chushengzhink/2026tibei-mspm0g3507-icm42688/README.md

# MSPM0G3507 通用双轮差速底盘模板

本工程面向立创·天猛星 MSPM0G3507 开发板、TB6612 双路电机驱动和两只 MG513X 霍尔编码器电机。

SW6五向键映射已在实物上确认：上/左/下/中/右依次对应PA14/PA15/PA24/PB24/PB25。默认固件恢复完整底盘自检，任何运动都必须由垂直中键确认；电气检查见 [WIRING.md](WIRING.md)，软件与标定原理见 [ROBOT_SETUP.md](ROBOT_SETUP.md)，现场逐项验收和数据记录使用 [HARDWARE_ACCEPTANCE.md](HARDWARE_ACCEPTANCE.md)。

## 默认能力

- 左右编码器均由四根 GPIO 双边沿中断完成软件 4× 解码。
- 每个车轮使用独立 PID、前馈、轮径标定和方向配置。
- 20 ms 轮速闭环，计数速度使用系数 0.35 的一阶低通滤波。
- 编码器低频约束与ICM42688短时角速度互补融合，输出编码器航向、融合航向和融合角速度。
- 差速中点积分里程计使用融合航向输出 `x_mm`、`y_mm`，同时保留累计距离和累计 tick。
- 提供轮速、线速度/角速度、定距、原地转向和圆弧非阻塞接口。
- 定距、转向和圆弧使用加减速轨迹；完成条件需连续三个周期进入 2 mm 或 1°窗口。
- 8 个控制周期无编码器反馈触发堵转保护，约 160 ms。
- 电机驱动绝对PWM硬限制为20000/50000，即40%；默认安全自检仍使用`PID 11500 + 前馈6000`，输出不超过原35%。
- LF04通用读取仍不参与默认自检；独立竞速工程由编码器里程生成路线前馈、编码器+IMU融合生成航向阻尼，LF04作为按置信度加权的横向残差，在统一轮差预算内同时控制。
- 直线、转向、圆弧和速度模式在运动层使用融合航向/角速度纠偏；单轮PID仍只使用编码器。
- IMU读错或超过100 ms未更新时无跳变退化为编码器航向。
- 10 Hz RAM遥测可保存600条；公开记录结构为52字节，RAM内部以44字节紧凑格式保存相同字段（x/y分辨率0.25 mm），并可在停车后通过UART0导出27列CSV。记录包含累计航向、速度、实际PWM、LF04纠偏量、路线/航向/最终轮差和可用/恢复状态。
- 断开12 V后可在开机前按住中键进入OLED滚动标定页，无需连接电脑即可读取左右相对tick和BAD增量。

MG513X默认采用13 PPR、1:28减速比、65 mm轮径：

```text
13 × 28 × 4 = 1456 tick/轮
π × 65 / 1456 = 0.1402497 mm/tick
```

理论值只用于首次启动。左右轮必须分别按实车滚动距离标定。

当前一组正反各1 m滚动样本得到暂定值：左轮 `0.1413727 mm/tick`，右轮 `0.1434926 mm/tick`。它们已写入默认配置，但仍需通过500 mm/1 m实车回归确认最终距离精度。

## OLED滚动标定入口

断开12 V，只保留5 V逻辑供电；开机前按住垂直中键并保持车体静止。IMU校准完成后显示 `ROLL C=ZERO`，第二、三行是左右有符号相对tick，第四行是相对BAD。首次进入自动建立零基线，之后每次中键有效按压只清零显示基线，不启动电机。断电后不按中键重启即可返回普通自检。详细记录方法见 [HARDWARE_ACCEPTANCE.md](HARDWARE_ACCEPTANCE.md)。

## 软件分层

```text
chassis_self_test / 用户任务
        |
        +-- chassis：非阻塞公共API、20 ms调度、遥测
        |      +-- chassis_motion：轨迹、融合航向/角速度反馈、堵转与急停
        |      +-- chassis_heading_fusion：编码器低频约束与陀螺仪短时预测
        |      +-- chassis_odometry：融合航向中点积分并保留编码器航向
        |      +-- motor_velocity：左右轮PID、前馈、速度滤波
        |
        +-- ml_encoder + ml_quadrature：GPIO软件4×解码
        +-- ml_motor_driver：TB6612方向/PWM和40%绝对硬限幅
        +-- icm42688_service：姿态、映射后零偏校正角速度和健康状态
        +-- line_sensor + chassis_track_line_control：LF04四路物理质心PD控制与方向优先仲裁
        +-- chassis_track_mission：编码器+IMU胶囊赛道主任务
```

常用入口在 `code/chassis.h`：

```c
chassis_init(&g_chassis_default_config);
chassis_set_wheel_speed(100.0f, 100.0f);
chassis_set_velocity(120.0f, 0.0f);
chassis_move_mm(500.0f, 120.0f);
chassis_rotate_deg(90.0f, 60.0f);
chassis_arc(300.0f, 180.0f, 100.0f);

while (1) {
    chassis_poll();
}
```

所有命令均为非阻塞调用。应用应持续执行 `chassis_poll()`，并通过 `chassis_get_status()`检查运行、完成或故障状态。

## 目录

- `ml_libs/`：板级GPIO、定时器、UART、I²C、电机、编码器和传感器驱动。
- `code/`：PID、底盘配置、里程计、运动控制、遥测、自检和可选循迹。
- `tests/`：可在PC上运行的纯算法测试。
- `examples/legacy_drawing_task/`：已从默认工程移除的历史任务代码，仅供参考。
- `examples/attitude_monitor/`：已从默认工程移除的独立姿态显示示例。
- `user/project.uvprojx`：默认Keil底盘自检工程。
- `user/project_track.uvprojx`：独立竞速工程，定义`CHASSIS_TRACK_MISSION_BUILD=1`。
- `user/project_ball.uvprojx`：独立杆球工程，定义`BALL_BALANCE_BUILD=1`，不编译或初始化底盘电机、编码器、LF04和IMU。
- `user/project_ball_q3.uvprojx`：第三题独立地形学习与强制救援工程，定义`BALL_Q3_BUILD=1`，只链接舵机、MaixCam、PB24、OLED和可选UART0遥测。
- `user/project_h456.uvprojx`：H4/H5/H6联合工程，定义`H456_COMBINED_BUILD=1`，同时运行底盘循迹和任意目标滚球闭环，不链接两个独立应用或第三问滚球遥测。

## H题第3小题杆球工程

杆球源码已按当前HAL融合，舵机信号使用PB27/TIMA1_CCP1的独立50 Hz PWM，MaixCam使用UART2 PB15/PB16和115200 8N1，TIMG6提供1 ms时基并以10 ms运行控制。当前默认`BALL_AUTO_CONTROL_DISABLED`并开放正式序列；正常上电先以1500 us安全初始化，再按现有2000 us/s斜率移动到1525 us水平零点，连续3帧有效视觉后显示`BALL READY C=GO`，由PB24启动一次`+5→-5`。正常READY、闭环、序列切换和重捕获恢复均以1525 us为零控制；运行中按PB24立即中止并回到1500 us，本次上电不再重新启动。开机前保持PB24仍进入人工标定模式并使用1500 us安全中心。

`BALL_BALANCE_ALLOW_SEQUENCE=1`已启用，题面仍按±1 cm验收；软件内部序列判定为`+5.0 cm/±0.8 cm连续10 ms（不检查速度）→ -5.0 cm/±1.0 cm且|速度|≤1.0 cm/s捕获 → 捕获后连续合格500 ms`，总超时5000 ms。位置越界、失视或无效帧会清零端点确认。正式+5改用3.0 cm/s巡航；停车距离门或剩余误差2.5 cm任一命中后，以`1.2×位置误差`连续降速并限制在3.0 cm/s，18 cm/s²制动估计、0.25 cm余量和速度D=0不变。负向接近仍以-4.7 cm为控制目标，但当负向速度过大且预测停车点逼近`-3.2 cm`时会提前切入`MINUS_BRAKE`做正向制动，避免拖到`-4.7 cm`之后才刹。最终低速进入题面±1 cm即锁存捕获，捕获后使用`3×位置误差-1×实际速度`并限制在±2 cm/s；连续500 ms合格后进入`COMPLETE`，随后普通带积分位置环继续把球向-5中心收敛。最后120 ms窗口内保留收口余量，但不再继续加重末窗助力；负端短时失视时会继续维持制动而不是立刻回到平衡脉宽。卡滞判断使用180 ms内朝目标真实位移不足0.12 cm而不是单像素速度。总静止故障门仍为500 ms。舵机1300–1700 us、位置PID 0.8/0.40/0.30、速度P=27、5秒门、视觉安全门、PB24和26列遥测均不变。该源码按用户要求尚未运行回归、ARMCC构建或实车验收，不能据此宣称达到5 s；第3题全程物理断开小车12 V电机电源。

当前遥测启动由正式序列实际进入`TO_PLUS_5/TO_MINUS_5`统一触发，不再只依赖PB24启动分支。26列CSV中的`control_output_us`现在相对1525 us水平零点解释，`servo_target_us`和`servo_current_us`仍为绝对脉宽。终态回中后OLED第四行显示实际记录数`CSV Nxxx D=OUT`，其中`xxx`必须大于0；若显示`CSV EMPTY REBOOT`，或发送`D`仅收到`EMPTY`，说明本次没有可用记录，必须保持机械安全并重新上电重跑，禁止用空表头继续调整PID。非空CSV仍保持26列、600条×44字节，重复`D`不会清空，只有确认文件完整后才发送`C`。

## H题第三题独立 Q3 工程（新方案）

`user/project_ball_q3.uvprojx` 是与旧 `project_ball.uvprojx` 完全隔离的第三题工程，定义 `BALL_Q3_BUILD=1`。它只初始化 PB27 舵机 PWM、UART2 MaixCam、TIMG6 1 ms 时基、PB24 和 PB2/PB3 OLED；UART0仅作可选诊断/导出，不参与启动许可。不链接底盘、电机、编码器、ICM42688、LF04 或旧 `ball_*` 控制器。反馈只有 MaixCam 的小球位置和采集时间。正式默认模式使用13点、-6～+6 cm、1 cm间隔的双向地形LUT；每点包含局部平衡偏置、正反滚动/脱困脉宽和制动能力。当前第三题重点是负向高速提前制动：当负向速度过大且预测停车点逼近`-3.2 cm`时先切`MINUS_BRAKE`，并允许60–150 ms短失视窗口继续保持制动，而不是把球拖到`-4.7 cm`之后再收口。仓库自带表只是1300～1700 us内的安全首次标定基线，不能当作实车最终地形表。

先做离线地形标定：球放O点并等到`Q3 READY`，UART0发送`K`只进入`MAP CAL ARMED`，必须再按PB24才开始`O→+6→-6→O`扫描；扫描中PB24立即回中急停。完成后固件自动输出`Q3_MAP_BEGIN...Q3_MAP_END`，`L`可重复导出。把完整内容保存为CSV，执行`python tools/q3_fit_profile.py map.csv code/q3_ball_profile_generated.h`，再全量Rebuild/Download。生成器会拒绝缺少-6～+6任一格、未双向经过、阈值方向错误或相邻脉宽突变超过60 us的数据。

正式上电时把球放在O点。连续有效视觉后，固件根据固化LUT自动做O点小幅双向探测，验证方向、估算本次响应缩放和中位修正，并主动回O；探测位置超过±1.2 cm、方向反复错误或4.5 s无法回中会锁存`Q3 CAL FAULT`，OLED第三行显示`WHY POS LIMIT`、`WHY PLUS DIR`、`WHY MINUS DIR`、`WHY RECENTER`或`WHY TIMEOUT`，UART0同步输出`REASON=... FROM=...`。只有OLED显示`Q3 READY C=GO`才允许PB24启动5 s计时。控制器按预测停止位置提前制动，球首次进入+4.2～+5.8 cm立即折返，不等待速度归零；负向接近仍以-4.7 cm为控制目标，但速度过大且预测停车点逼近`-3.2 cm`时会先切`MINUS_BRAKE`，在60–150 ms短失视窗口内继续保持制动。最终低速进入-5.8～-4.2 cm后改以-5.0 cm保持，捕获中若再次高速穿越会退回强制动，直到`|速度|≤1 cm/s`连续80 ms后进入`Q3 PASS HOLD`；若已进入最后120 ms窗口，则满足终点低速条件可立即进入`Q3 PASS HOLD`。PASS后继续视觉保持，按PB24才回中并开放CSV导出。

卡滞判断使用180 ms内朝目标真实位移不足0.12 cm而不是单像素速度。第一级使用本格脱困脉冲；仍不动则反方向轻摇最多50 ms/0.25 cm，再向目标方向打到1300或1700 us安全边界160 ms，最多两轮，之后不提前ABORT而由5 s总门收口。进入最终-5合法带后禁止脱困把球推出。视觉年龄达到60 ms立即取消极限救援并回局部平衡，150 ms仍无有效帧才锁存失视故障并回1500 us安全中位。

MaixCam脚本仍为`maixcam/q3_maix.py`，继续输出32字节`<IhhffB3x>`帧且只识别小球；屏幕角落会显示`TX Q3 ttyS2 115200`、TX计数和循环间隔，超过250 ms会标`SLOW TX`。Q3 OLED应用已独立重写：上电页为`Q3 TERRAIN CTRL`，控制核心初始化期间第四行会依次显示`CORE START`、`CORE UART2`、`CORE SERVO`、`CORE TIMG6`、`CORE SAFE`和`CORE OK`；若某一步内部卡死，屏幕会停在最后一个`CORE xxx`阶段。core成功后会立即强制整页刷新到真实等待页，避免第4行残留`WAIT CORE`，随后才尝试初始化可选UART0。`Q3 PLACE BALL O`表示MSPM0正在等待视觉/O点条件，第三行会显示`NO VISION RX`、`BALL LOST`、`LOW SCORE`、`SLOW FRAME`、`VISION 1/3`、`VISION 2/3`或`MOVE TO O`；WAIT阶段慢帧仍允许累计到3帧进入自动微调，正式运动视觉超时安全门不放宽。UART0可用时发送`V`可输出当前视觉诊断计数、帧间隔和`diag=`分类。若控制核心初始化返回失败，会显示`Q3 CORE FAIL / STAGE UART2|SERVO|TIMG6|SAFE / ERR nn`并保持安全停机；若此时UART0可用，也会输出具体阶段和错误码。非运动100 ms只写变化行；自动微调、地图扫描和正式运动中只在阶段切换时更新第一行，其余行保持预先写好的`PB24 E-STOP`等静态提示。UART0空闲命令为`V`视觉诊断、`K`标定、`L`地图导出、`A/W`地形/备用波形模式和`D/C`正式CSV导出/清空；这些命令不能启动运动，PB24仍是唯一运动确认和运行急停。UART0不可用时Q3仍可运行，只是不能用串口命令或导出CSV。正式遥测为512条×40字节、10 ms周期、22列，包含LUT格、响应缩放、预测停止点、停滞进展和救援阶段/次数。最终仍须在现有μVision空闲时全量Rebuild并检查唯一32 KB SRAM布局。

## H题第五题

第五题能力已并入 `user/project_h456.uvprojx`，不再保留独立 `user/project_h5.uvprojx`。
第五题相关的 H5/H6 参数、循迹和滚球联动说明请直接看下面的 H4/H5/H6 联合工程。

## H题第4/5/6小题联合工程

联合固件上电默认进入H6，默认使用150 mm/s²加减速；H4为220 mm/s直线巡航，但启动后前1200 ms先用100 mm/s²柔起步，之后恢复150 mm/s²；H5/H6使用210 mm/s巡航，并在起步前1200 ms先用100 mm/s²柔起步、之后恢复120 mm/s²，从约5580 mm开始允许A点航向门计数。H4在启动后1500 mm首次通过B时冻结评分时间，H5/H6在进度达到5932 mm且累计航向连续3个20 ms周期进入355°～365°后冻结通过A的评分时间。通过后仍由LF04循迹并平滑减速，不执行第2问终点回正。H4/H5目标固定0 cm；H6不再用左右键预设目标，Maix有效且球位于±12.5 cm内时，MSPM0会先用当前厘米位置作为临时保持目标，避免上电追0 cm。READY前只要求球位于±12.5 cm且速度≤1 cm/s，PB24启动瞬间再由MSPM0锁定当前Maix厘米位置作为整圈滚球目标。上/下键只切换H4/H5/H6，方向键永不启动，PB24仍是唯一启动和运行急停键。

H4直线段使用单独的温和LF04参数：普通纠偏18%且不超过60 mm/s，外侧单探头28%且不超过80 mm/s。若融合航向相对启动方向偏离达到6°，H4临时进入航向优先修正，暂停LF04继续加大轮差；回到3°以内后恢复普通LF04融合。该保护只用于H4的A到B直线。H5/H6仍使用210 mm/s巡航，但弯道线控改为更温和的普通20%/70 mm/s、外侧单探头22%/60 mm/s、B0曲线保持16%/50 mm/s，并在曲线退出时加入120 ms渐退窗，以降低BC/DA弯道对滚球的横向冲击。H5/H6在CD第二直线中前段3200-4200 mm还会把航向反馈临时限到0.16 rad/s，并把最终轮差变化限制为每20 ms不超过8 mm/s，窗口外立即恢复当前控制。

启动前必须同时满足H456专用IMU静止校准约1.5秒、LF04白底连续稳定、Maix连续3帧有效，以及滚球稳定门：H4/H5为小球在目标±0.8 cm且速度≤1 cm/s连续500 ms，H6为小球位于±12.5 cm且速度≤1 cm/s连续500 ms；校准期间移动车体仍会清零重来。H6在校准、SETUP和READY期间都会用当前Maix位置更新临时目标，PB24启动边沿再锁定一次目标；`maixcam/h6_maix.py`仍只单向发送32字节视觉帧，不读取PB24也不改变协议。READY后若PB24尚未松开，OLED第四行显示`REL PB24`且不会启动；必须松开后看到`C=GO U/D=MODE`，再按PB24才会锁定并启动。PB24启动后叠加线性淡出的滚球控制偏置：H4为+60 us/6000 ms，H5为+100 us/6000 ms；H6按锁定目标分档，`target_cm>=+8 cm`为+190 us/5000 ms，`+3 cm<=target_cm<+8 cm`为+160 us/3000 ms，`-3 cm<target_cm<+3 cm`为+60 us/3000 ms，`-8 cm<target_cm<=-3 cm`为+60 us/5000 ms，`target_cm<=-8 cm`为+80 us/6000 ms。现有滚球闭环已经是位置P/D/I加速度P/D串级PID；负侧已从方向修正进入补偿降档，用于减少靠中心侧偏移，暂不新增PID。补偿不改变已锁定的`target_cm`，评分、±1 cm/±2 cm安全门和CSV仍按真实刻度目标计算。运行期OLED冻结；评分前误差达到±1.20 cm会立即锁存本轮滚球FAIL，±1.00～±1.20 cm之间需连续超过500 ms才锁存FAIL；连续100 ms超过±2 cm、视觉超时、脱困故障、底盘堵转或PB24急停仍会立即安全停车并把舵机回到1500 us。正常通过并停稳后继续保持滚球目标，结果页显示冻结时间和最大误差；再按一次PB24才回到1500 us并开放UART0导出。

H456上电后会先显示`H456 BOOT`。若OLED初始化成功但后续模块初始化失败，屏幕会停在`H456 INIT FAIL`并显示`STATUS xx`，避免被清屏黑屏误判为OLED损坏；第四行若为`LINE CFG FAIL`表示LF04线控参数校验失败，不是接线故障。如果连BOOT页都没有，优先检查OLED供电和PB2/PB3接线。

联合遥测只使用一个600条×44字节缓冲：H4每20 ms记录、覆盖12 s，H5/H6每60 ms记录、覆盖30 s。CSV记录底盘进度/航向/速度/PWM/LF04以及滚球目标/位置/区间误差峰值/速度/控制量/舵机、Maix原始`raw_x_px`和视觉年龄，并追加`expected_heading_deg`、`heading_error_deg`、`heading_gate_met`；`score_elapsed_ms`是本轮最终锁存结果，不是逐行实时计时。`maximum_ball_error_cm > 1.0`但`ball_score_passed=1`表示只出现短时/轻微边界超限，未达到评分确认门。导出后调参前先剔除坏行：每行必须35列、`time_ms`单调、舵机值在1300-1700 us合理范围内；字段缺失或粘行不参与最大误差计算。UART0仍使用`D/C/BUSY/EMPTY`。联合构建把旧底盘遥测容量缩为1且不链接第三问26.4 KB缓冲，完整Map仍须在首次Rebuild后确认唯一`RW_IRAM2`不超过`0x8000`。

## 构建

运行 PC 主机测试（需要 `gcc`）：

```text
powershell -NoProfile -ExecutionPolicy Bypass -File .\tests\run_host_tests.ps1
```

主机测试只验证可移植算法和安全状态机，不能替代 ARMCC 全量构建或实车验收。

Keil 全量构建：

```text
D:\Keil_v5\UV4\UV4.exe -b user\project.uvprojx -j0
```

杆球工程在μVision空闲时单独全量Rebuild `user\project_ball.uvprojx`；联合题使用`user\project_h456.uvprojx`。默认、竞速、滚球和联合四个工程均要求`0 Error(s), 0 Warning(s)`，不得并行启动UV4。

竞速工程不要在默认架空验收前烧录；验收完成后在现有μVision窗口打开并Rebuild：

```text
user\project_track.uvprojx
```

同一竞速固件还提供独立的纯LF04诊断入口：上电前按住上键，完成白底与IMU校准后松开上键；进入`LF ONLY READY`后用上/下键选择60、120、200、280或350 mm/s。READY页不检查当前B0-B15位型，按中键即可启动。转向只取LF04输出，IMU只记录，编码器仍负责左右轮闭环、累计里程和堵转。该模式不再按距离自动停车，可完整运行一圈；回到起点后按中键执行锁定急停，保持5 V时可先导出CSV，之后必须重新上电才能再次运行。B0会按当前任务速度无限期保持最后有效四路误差，初始B0按居中直行；所有`B1-B15`均为正常可用位型。恒定`350 mm/s`且越过6141.6 mm后仍运行的CSV表示进入了该诊断模式，不代表正式融合竞速。

正式竞速上电时不要按住上键，READY首行必须显示`RACE FUSION`。完成白底和IMU校准后，将车尾约定测试点放在A线、车头对准AB；READY页不检查当前LF04位型，按中键立即以当前编码器和融合航向建立零点并顺时针启动。路线为1.5 m直线、R500 mm半圆、1.5 m直线、R500 mm半圆，总长6141.6 mm。默认stage 0直线/弯道均为360 mm/s、加减速度400 mm/s²；stage 1/2仅作为未启用的可选档把直线依次提高到380/400 mm/s，弯道仍为360 mm/s。末段降至100 mm/s。

编码器里程生成AB/BC/CD/DA的期望航向和R500前馈，融合航向误差以`Kp=4.0`和`±0.35 rad/s`限幅修正，现有速度模式继续提供融合角速度反馈。理论路线长6141.6 mm只用于路线几何；车尾A点的首轮实测停车参考为5932 mm。航向门从DA起点约4570.8 mm开始允许计数，连续3个20 ms周期进入355°–365°即锁存，随后即使超过365°也不清除；终点从5742 mm减速，编码器进度达到5919 mm且航向门已锁存才制动。到5982 mm仍未同时满足则锁停并显示`FAULT LAP CHECK`。红外位型和A点横线均不参与停车判定。

制动后两轮连续3周期低于20 mm/s才进入`ALIGN TO START`原地回正。中键启动时锁存的融合航向仍是物理起点方向参考，但终点专用`finish_alignment_heading_bias_deg=+37°`补偿实车一圈后的累计航向偏差；回正误差为`wrap(start+37°-current)`，正值从车顶观察为顺时针。巡线航向继续使用`Kp=4.0`，终点回正独立使用`Kp=2.0`和`±0.35 rad/s`，LF04继续记录但权重为0。补偿误差首次进入±1°（当前启动零点下396°–398°）即锁存停车；双轮完全停稳前即使融合航向离窗也不得反向。两轮连续3周期低于20 mm/s后以±2°（395°–399°）验收，超出才从静止重新微调。主动回正限时3秒；截止前已锁存停车时允许最多300 ms无动力停稳宽限。初始误差超过45°、主动阶段超时或宽限后仍未停稳/超差会显示`FAULT ALIGN`并锁停。OLED `TIME`与CSV `lap_total_ms`都从启动中键计到回正完成，包含巡线、制动和回正；完整圈航向门仍单独使用360°目标。`LAP COMPLETE`只表示状态机正常结束，第四行按20秒和编码器估算±20 mm分别显示`LAP CHECK PASS`、`TIME LIMIT FAIL`、`EST POS FAIL`或`TIME+POS FAIL`；位置结果不代表IMU故障，也不替代外部尺量。

LF04从左到右为PA31/PA12/PB8/PA27，探头中心相对模块中心为`-40.25/-7.25/+7.25/+40.25 mm`。所有低电平探头按`error=-average(position)/40.25`计算归一化四路质心：左侧黑线得到正误差并使左轮减速、右轮加速，右侧完全对称；B6、B9、B15质心为0。所有`B1-B15`均可用，只有`B0`表示丢线。控制器每20 ms执行`Kp=1.2、Ki=0、Kd=0.20`的PD控制；首个有效样本预装D历史，避免启动冲击。普通位型采用当前中心速度的22%纠偏且总偏置不超过90 mm/s；B1/B8最外侧单探头立即采用35%纠偏和120 mm/s总偏置上限。左右误差直接反向时首周期把有效误差置0，连续第二周期才接受；居中和同侧变化不延迟。正式竞速恢复已验证的LF04方向优先仲裁：B0无限保持最后确认误差和增强状态；LF04纠偏非零时只接受同向的路线前馈与航向反馈，反向路线量不得抵消或反转LF04回线方向；LF04居中时路线与航向正常接管。红外不参与终点双门，运行中中键仍立即急停。

纯LF04和正式竞速都不启用实验性弯道方向记忆。B1/B8立即使用35%/120 mm/s增强，B0继续保持最后确认的质心误差；任意新有效位型在现有反向确认规则后立即接管。实测表明原弯道记忆可能在直线入口继续输出`+89～+120 mm/s`并造成持续转向，因此31%/110 mm/s保持量和1200 mm退出门只保留为未启用的实验配置。正式竞速仍分别记录路线前馈和航向反馈，但只有在不违背非零LF04回线方向时才参与最终轮差。

GPIO输入初始化会先清除遗留输出使能；竞速初始化、启动边沿和每次20 ms采样都会把四路LF04重新确认为普通GPIO上拉输入。LF04固定使用白底高、黑线低逻辑，期望白底为`WF`，归一化采用`(~R)&0x0F`，不再把开机瞬态保存为极性基线。IMU校准期间还必须连续10个20 ms样本得到`RF`才允许进入READY；否则保持停车并显示`LF WHITE WAIT`。启动前重申失败会禁止启动，运行中失败会立即锁停并显示`LF GPIO FAULT`。RUN第四行每秒交替显示`Rr Ww Bb`与`LFb Ln DnHn`，分别用于核对原始电平/固定白底期望/归一化黑线位，以及丢线恢复/距离门/航向门。

UART0固定为PA10/PA11、115200、8N1、无流控。竞速或纯LF04模式完全停稳后发送单个`D`导出纯27列CSV，确认文件保存后再发送`C`清空RAM；运行和制动期间两者均不执行，仅每秒最多回复一次`BUSY`。`line_correction_mm_s`仍表示LF04原始分量，新增`mission_progress_mm`、`expected_heading_deg`、路线前馈轮差、航向反馈轮差、红外权重和最终轮差，可直接还原正式仲裁。纯红外中键锁停会结束遥测会话并写入纠偏为0的最终快照。编码器和融合航向为不回绕的累计值，原始IMU Yaw保留回绕诊断；同时间戳立即采样覆盖上一条，导出的时间戳严格递增。SSCOM必须关闭“发→/收←”方向标记、时间标签、定时发送和自动换行，只发一次ASCII `D`或十六进制`44`并等待完整导出。

验收标准为 `0 Error(s), 0 Warning(s)`。烧录和上电前必须先阅读 `WIRING.md`，实车自检和标定步骤见 `ROBOT_SETUP.md`。

Fusion算法授权保留在 `ml_libs/FUSION_LICENSE.md`，硬件规格书和原始资料均未从仓库删除。

杆球第三题当前控制基线：1500 us为安全/人工/导出回中，1525 us为正常READY与闭环水平零点；Maix分段`FIXCM`为唯一厘米输入；正向3.0 cm/s巡航、18 cm/s²制动估计、2.5 cm固定接近区和1.2倍位置参考；负向接近为3倍位置参考，最终捕获只允许低速进入并以-5.0 cm保持，捕获中高速穿越会退回强制动。正式序列脱困启动前速度绝对值必须≤1 cm/s。
