chushengzhink/2026tibei-mspm0g3507-icm42688/tmp/pdfs/route_review/page-1.png

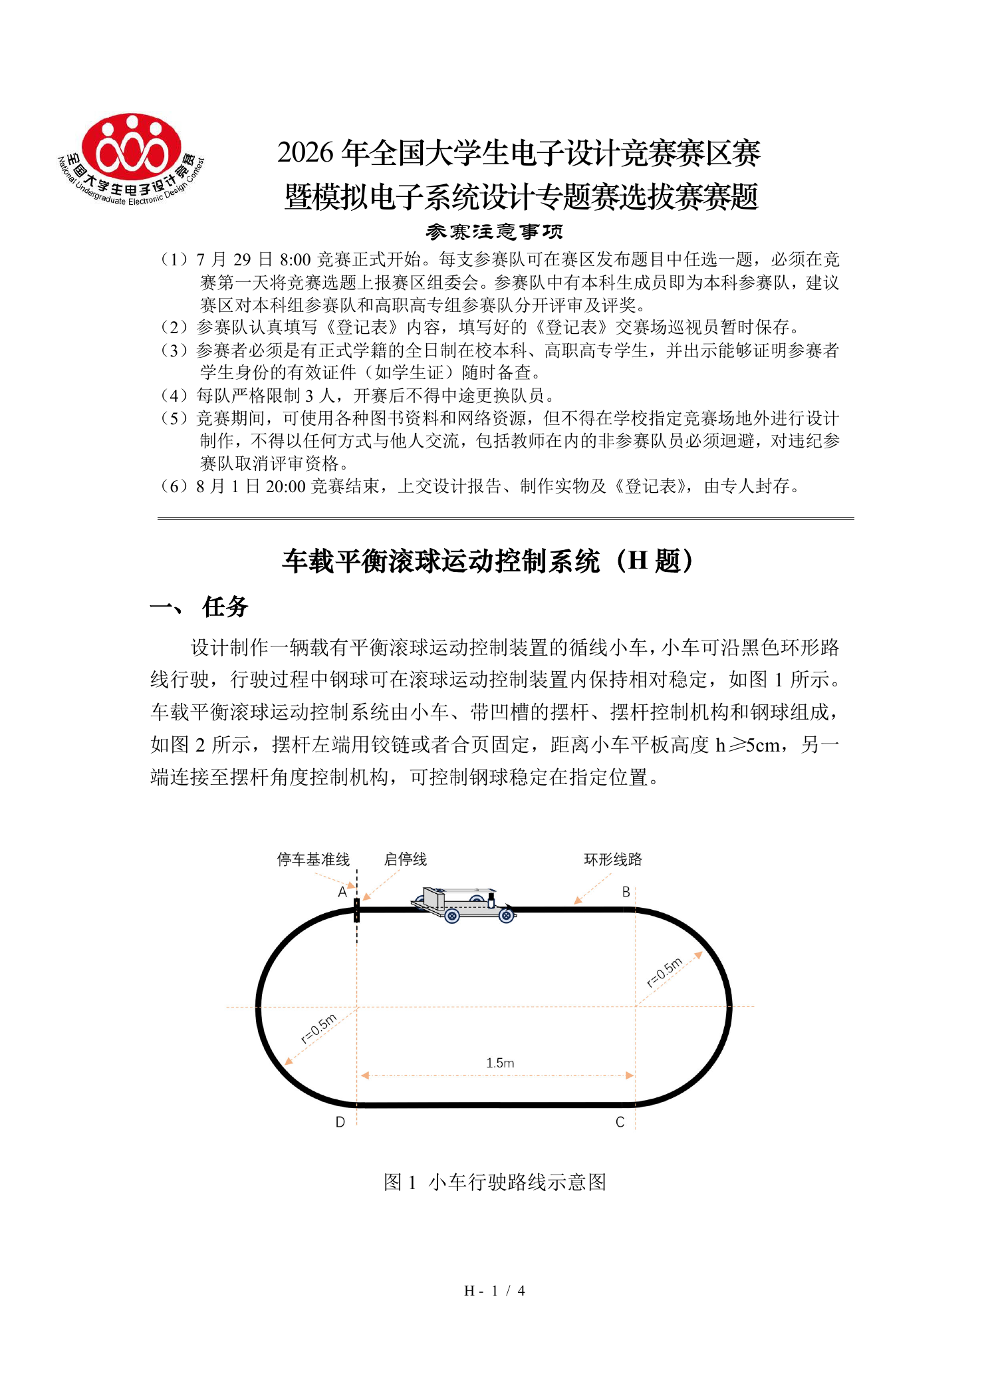
tmp/pdfs/route_review/page-1.png
