chushengzhink/2026tibei-mspm0g3507-icm42688/红外循迹模块.png

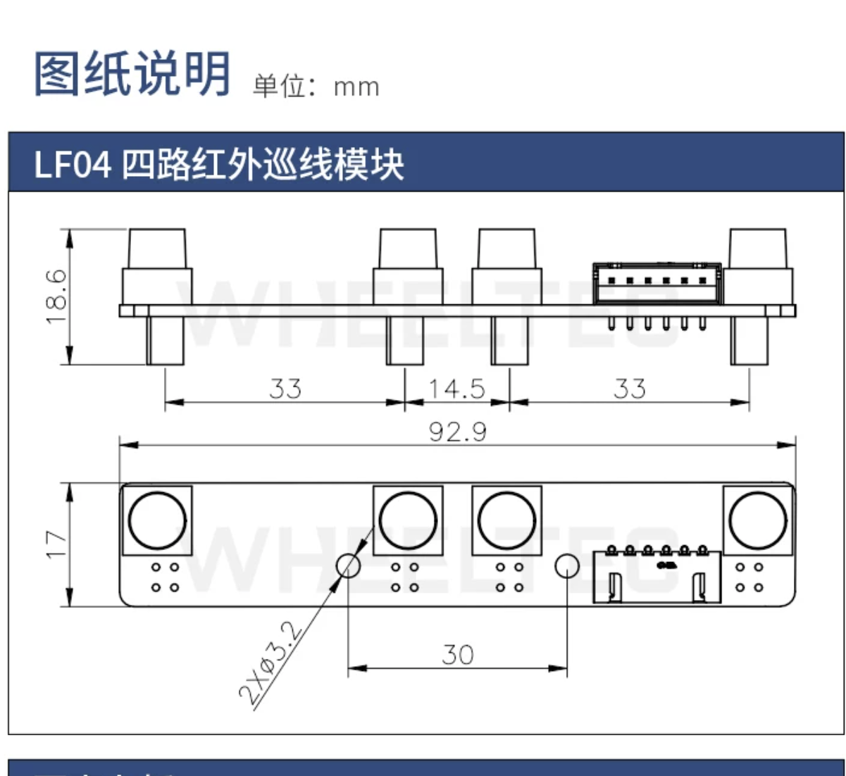
红外循迹模块.png
