chushengzhink/2026tibei-mspm0g3507-icm42688/ROBOT_SETUP.md

# 通用双轮底盘自检、标定与API说明

本文件说明自检行为、标定原理和公共 API；实际烧录、架空、地面测试和数据签字请逐项填写 [HARDWARE_ACCEPTANCE.md](HARDWARE_ACCEPTANCE.md)。

## 默认自检流程

SW6动作映射已经实测确认，当前构建设置为 `CHASSIS_SW6_MAPPING_DIAGNOSTIC=0`，恢复完整底盘自检。垂直中键对应PB24，方向键不会启动运动；开机保持右键PB25只会进入永久停车的UART诊断页。

### 中键操作

一次有效中键操作是垂直按下0.1–0.3秒后完全松开。程序使用60 ms时间消抖：过快轻触可能被过滤，长按只产生一次事件，下一次操作前必须先松开。IMU校准期间不会接受运动确认；唯一例外是开机前持续按住中键，会在校准完成后进入不驱动电机的滚动标定页。

### OLED提示与操作

| OLED提示 | 用户操作 | 程序动作 |
| --- | --- | --- |
| `KEEP STILL` | 不触碰小车 | IMU采集300个静止样本 |
| `ROLL C=ZERO` | 释放中键后手推标定；中键可重新清零 | 显示左右相对tick和相对BAD，不发送运动命令 |
| `LIFT+PRESS KEY` | 架空两轮，垂直按中键 | 左正、左反、右正、右反、双轮闭环各约1秒 |
| `FUSION F/S STOP` | 12 V断开时手动转动车体；串口发送`S`退出 | 10 Hz记录编码器、IMU与融合结果，不发送运动命令 |
| `GROUND+PRESS KEY` | 放到平地后按中键 | 执行500 mm直线 |
| `PRESS FOR +90` | 确认周围安全后按中键 | 执行+90°原地转向 |
| `PRESS FOR -90` | 按中键 | 执行−90°原地转向 |
| `TEST COMPLETE` | 不再按键 | 自检完成，电机保持停止 |
| 任一电机运行页面 | 按中键 | 立即锁定急停，必须重新上电 |
| `SELF TEST ERROR` | 断开12 V后排查 | 保持停车，不继续后续步骤 |

首次运动前应能够立即断开12 V，架空时不要手持车轮或让线缆靠近轮胎。

### OLED滚动标定模式

1. 物理断开12 V，只保留5 V逻辑供电；将车辆放在样本起点。
2. 开机前按住垂直中键，并在整个IMU校准期间保持车体静止和中键按下。
3. 出现 `ROLL C=ZERO` 后松开中键。首次进入已自动建立零基线。
4. 第二、三行分别显示 `L +0000000`、`R +0000000` 格式的有符号相对tick；第四行显示自基线以来的 `BAD` 增量。
5. 每完成一个样本后记录屏幕；需要下一个样本时按住中键超过60 ms再松开，确认tick与BAD重新从0开始。
6. 标定页内中键不会启动电机，上、左、下、右也无功能。退出只能断电，然后不按中键重新开机。

显示值是相对最近一次清零的增量，不会清除底层累计计数。七位tick超过范围时饱和显示为 `±9999999`。

### 校准与AB状态显示说明

第二行 `L AxBx R AxBx` 显示PB23、PB12、PB4、PB5的实时GPIO电平，不再显示解码器内部缓存。编码器插头全部拔掉时，内部上拉应使其稳定显示 `L A1B1 R A1B1`。固件将每一行先组成最终16字符内容，再通过批量软件I²C写入；不会先显示占位数字0再覆盖真实数字，因此正常情况下不应出现0/1假闪烁。

出现 `MOVE RETRY` 时，第四行显示类似 `G:034 A:101`：

- `G`是陀螺仪模长的0.1 dps单位，`034`表示3.4 dps。
- `A`是加速度模长的0.01 g单位，`101`表示1.01 g。
- 静止校准要求陀螺仪总模长小于3.0 dps、加速度模长处于0.85–1.15 g。

若校准能够正常采样，第四行必须从 `CAL:000/300`连续增加到300。它不会再永久用`CAL:000`掩盖读取错误或主循环超时。

校准结束后，第四行按实测物理通道顺序显示：

```text
K U1L1D1C1R1
```

`U/L/D/C/R`依次表示上、左、下、中、右，对应PA14、PA15、PA24、PB24、PB25。未操作时均为1，操作对应方向时只有自己的位变为0。只有`C`参与确认和急停。

### ICM42688安装方向

当前模块元件面朝下并水平安装。传感器 `+X` 指向车尾；站在车头正前方、面向车尾观察时，传感器 `+Y` 指向观察者右侧，也就是车辆自身左侧；传感器 `+Z` 指向地面。车体姿态坐标保持 `+X` 向前、`+Y` 向左、`+Z` 向上，因此配置为：

```text
source_axis = {X, Y, Z}
axis_sign   = {-1, +1, -1}
```

从上方观察，Fusion库输出仍遵循逆时针正、顺时针负。当前实车运动接口和编码器航向沿用既有约定：`+90°`实测为顺时针，所以融合入口使用独立的`imu_heading_sign=-1`将IMU角速度转换到编码器正方向；该符号转换不改变三维安装映射。IMU每次上电仍必须静止完成300样本校准。

20 ms底盘周期使用陀螺仪短时预测、编码器低频约束形成融合航向；时间常数为1.0 s，融合角速度采用75% IMU和25%编码器。IMU超过100 ms未更新或单周期变化超过25°时，系统连续退化为编码器航向，恢复时不跳变。单轮PID仍只使用编码器，IMU只在底盘运动层参与直线航向、转向/圆弧进度及角速度反馈。

### 按键没有反应时的排查顺序

1. 查看第四行 `K UxLxDxCxRx`，未操作时五位都应为1。
2. 若对应动作不能把自己的位变为0，断开5 V和12 V，检查开关触点、公共GND、焊点和对应GPIO走线。
3. 若一个动作出现多个0，检查信号间短路。
4. `C0`能正常显示但没有启动时，确认页面已经进入`LIFT+PRESS KEY`且按住超过60 ms，并先完全松开后重试。
5. 方向键只用于电平诊断，按上、左、下或右不会启动自检。

更完整的TM-2027六脚定义、内部上拉原理和万用表通断测试见 [WIRING.md](WIRING.md)。

## 编码器验收

软件4×解码在PB23/PB12/PB4/PB5四根线上均使用双边沿中断。AB状态表只接受相邻转换；`00→11`、`01→10`等两位同时变化不增加位置，只增加非法转换计数。

静止时某轮若在 `A0B0` 与 `A1B1` 之间反复切换，表示A、B两位正在同时变化，不是正常正交相位。固件已对双边沿输入启用GPIO硬件迟滞以抑制窄噪声，但不会把这种非法转换计入位置。若BAD仍持续增加，应分别测量两相信号：检查A/B是否误并联、编码器3.3 V与GND是否稳定、插头针序是否正确；长线或开漏输出可在A、B各增加约4.7 kΩ到3.3 V的外部上拉，不能靠软件忽略错误来替代电气修复。

1. 用万用表或示波器确认四路高电平约3.3 V，不超过3.6 V。
2. 拔掉两只编码器插头时，确认四路实测约3.3 V且OLED稳定显示 `L A1B1 R A1B1`。
3. 如需逐脚验证，可将PB23、PB12、PB4、PB5分别通过1 kΩ电阻接GND；对应A/B位应稳定变为0，断开后恢复1。
4. 进入OLED滚动标定页，缓慢手转左轮输出轴一整圈，相对计数绝对值应接近1456。
5. 中键清零后对右轮重复一次，相对计数绝对值也应接近1456。当前实测左轮1456、右轮绝对值1498，BAD增量均为0。
6. 正向推动车体时左右累计计数都应为正。
7. 分别正反转至少10圈，非法转换率应低于0.1%。

方向不一致时优先核对A/B接线。确认接线无误后，只修改 `code/chassis_config.c` 中对应轮的 `encoder_sign` 或 `motor_sign`，不要同时随意交换多组线。

## 轮距与每tick距离标定

默认值：

```text
left mm_per_tick   = 0.1413727
right mm_per_tick  = 0.1434926
effective_track_mm = 214.2
```

`CHASSIS_DEFAULT_MM_PER_TICK=0.1402497` 仍保留为65 mm轮径的理论参考值，不再作为当前左右轮的实车配置。当前 `214.2 mm` 是两轮接地点中心距的首轮实测值。旧值 `128.6 mm` 下，双向 90°命令均只转到约 54°；按 `90 × 128.6 / 214.2 ≈ 54.0°` 计算，两者相互吻合。

### 左右轮独立标定

1. 断开12 V并进入OLED滚动标定页，在实际比赛轮胎、载荷和地面条件下让车辆直线滚动1–2 m。
2. 每次在起点用中键清零显示基线；每个方向至少做5次，记录实际距离和左右相对tick。
3. 对每轮计算 `mm_per_tick = 实际距离 / |相对tick|`。
4. 去掉明显打滑数据，取稳定样本平均值，分别写入左、右轮配置。
5. 再执行1 m直线，基线目标是距离误差不超过1%。

当前用户选择先采用一组正反各1000 mm样本：前进 `L+7037/R+6951`，后退 `L-7110/R-6987`。按合并距离除以合并绝对计数得到：

```text
left  = 2000 / (7037 + 7110) = 0.1413727 mm/tick
right = 2000 / (6951 + 6987) = 0.1434926 mm/tick
```

这是一组正反方向的暂定值，不等同于已经完成多次重复性验证。写入后必须重新验证500 mm直线和双向90°；若距离超差或偏移明显，应增加滚动样本，不先调整PID。

### 有效轮距标定

1. 先重复执行双向90°，再执行双向360°。
2. 使用外部角度基准记录实际转角，按 `新轮距 = 旧轮距 × |命令角度| / |实际角度|` 计算修正值。
3. 实际转角小于命令角度时增大 `effective_track_mm`；实际转角大于命令角度时减小。
4. 每次只调整一个参数并重复至少5次。
5. 基线目标是90°转向误差不超过2°。

有效轮距包含轮胎侧滑等综合影响，通常不等于尺量的几何轮距。更换地面、轮胎或载荷后应重新标定。

## 轮速参数

默认20 ms控制周期下：

| 参数 | 默认值 |
| --- | --- |
| KP | 700 |
| KI | 55 |
| KD | 0 |
| 前馈 | 6000 |
| PID输出限制 | ±11500 |
| PID积分限制 | ±5750 |
| 默认自检最大合成输出 | 约±17500（35%） |
| 电机驱动绝对PWM硬限制 | ±20000（40%，仅竞速配置可用满） |
| 速度滤波系数 | 0.35 |

先标定机械方向和编码器比例，再调整PID。推荐从低速架空测试开始，观察目标轮速、滤波轮速和PWM，不要用提高PWM限幅掩盖接线、摩擦或供电问题。

## 非阻塞API

初始化并持续轮询：

```c
if (chassis_init(&g_chassis_default_config) == ML_STATUS_OK) {
    while (1) {
        chassis_poll();
        status = chassis_get_status();
    }
}
```

运动命令：

```c
chassis_set_wheel_speed(left_mm_s, right_mm_s);
chassis_update_wheel_speed(left_mm_s, right_mm_s);
chassis_set_velocity(linear_mm_s, angular_rad_s);
chassis_update_velocity(linear_mm_s, angular_rad_s);
chassis_move_mm(distance_mm, max_speed_mm_s);
chassis_rotate_deg(angle_deg, max_angular_deg_s);
chassis_arc(radius_mm, angle_deg, max_speed_mm_s);
chassis_stop();
chassis_emergency_stop();
chassis_reset_pose(x_mm, y_mm, heading_deg);
```

- 定距允许正负距离。
- 当前实车约定中，转向角正值为从车顶向下看的顺时针，负值为逆时针；编码器航向和融合航向均使用该约定。
- `chassis_update_wheel_speed()`只更新已运行的直接左右轮目标，不重置PID或堵转计数，并始终保持`CHASSIS_MODE_WHEEL_SPEED`，不会叠加IMU角速度反馈；首个命令仍调用`chassis_set_wheel_speed()`。
- `chassis_update_velocity()`只更新已运行的`VELOCITY`命令，不重置PID、堵转计数或融合基线；赛题20 ms循环必须使用它，首个命令仍调用`chassis_set_velocity()`。
- 圆弧半径必须大于半轮距，角度正负决定转向方向，车辆默认向前沿弧线运动。
- 新的定距/转向/圆弧命令在另一个轨迹命令运行时返回 `ML_STATUS_BUSY`。
- 急停会锁定后续运动，必须重新初始化或重新上电。
- 默认自检通过`chassis_set_imu_sample()`同步输入原始Yaw、映射且扣除零偏后的车体Z轴角速度和时间戳；旧`chassis_set_imu_yaw()`仅保留为不启用融合的兼容接口。

## 可选LF04调用

```c
line_sample_t sample = line_sensor_read();
if (!sample.io_fault && !sample.lost) {
    uint8_t active_sensors = sample.black_bits;
}
```

竞速工程由`chassis_track_line_control`按`-40.25/-7.25/+7.25/+40.25 mm`计算四路有效探头的物理质心；`error=-average(position)/40.25`。红外环使用`Kp=1.2、Ki=0、Kd=0.20`的PD控制，首个有效样本不产生D冲击，PID输出限制`±1`。普通位型使用22%纠偏和90 mm/s总偏置上限，B1/B8最外侧单探头继续立即使用35%和120 mm/s。直接左右反向首周期抑制为0，连续第二周期或随后B0确认；居中和同侧变化立即接受。B0无限期复用最后确认误差且保持当前任务速度及外侧增强，首次B0按误差0且不增强处理。

纯LF04模式使用同一PD且不启用实验性弯道方向记忆。B1/B8仍立即使用35%/120 mm/s外侧增强；B0按原速度无限保持最后确认误差，新有效位型经两周期反向确认后立即接管。曾启用的31%/110 mm/s长期保持和1200 mm退出门会在直线入口继续保持弯道方向，现已关闭。正式竞速在同一红外优先控制之上加入编码器里程与IMU融合路线辅助，纯LF04中的IMU仍只记录不转向。

## RAM遥测与UART0

### UART0安全诊断模式

1. 物理断开12 V，开机前按住右键PB25，并保持车体静止完成IMU的300样本校准。
2. 出现`UART DIAG STOP`后松开右键。该状态不会执行任何运动命令，中键和其他方向键也无效；退出只能断电后不按右键重启。
3. OLED第二行正常应为`BRD I0002 F11`，表示4 MHz MFCLK、16×过采样和115200波特率的实际硬件分频。
4. 固件每秒自动发送`UART0,115200,TX,nnnn\r\n`，无需先发送命令。第三行显示横幅次数和TX超时数。
5. 发送一个ASCII `D`时，第四行应显示`RX44 E00 O0000`，串口回复`RX,44,ERR,00\r\n`。诊断模式把所有输入都当作测试字节，不会执行`D/C`、导出CSV或清空RAM。
6. 横幅乱码但OLED分频正确且TX次数增加时，检查PA10到适配器RX、共地、3.3 V TTL和约`8.68 us/bit`波形；横幅正确但不是`RX44`时，检查适配器TX到PA11。`E`非0表示overrun/break/parity/framing/noise，`O`为软件队列溢出。

诊断通过后必须断电、不按右键正常启动，再进行空缓存CSV验证。自动横幅只存在于诊断模式，不会混入正常CSV。

运动时每100 ms记录一次；`LIFT+PRESS KEY`页面发送`F`后，停车状态也按相同周期记录。竞速制动开始后会自动继续被动采样；首次停稳后转入原地回正并恢复运动采样，最终回正停稳才结束会话。共600条，缓冲满后停止新增并置溢出标志，不覆盖旧数据。立即采样若与上一条时间戳相同会覆盖上一条，较小时间戳会被拒绝，因此CSV时间戳严格递增。公开记录结构为52字节，RAM内部以44字节紧凑格式保存同等字段；tick和航向保持原精度，x/y分辨率为0.25 mm：

- 时间戳、左右累计tick：32位整数。
- x/y：32位浮点毫米。
- 编码器/融合航向：有符号32位0.01°累计值，可完整显示180°、270°和约360°；原始IMU Yaw仍为有符号16位回绕诊断值。
- 融合角速度：有符号0.01°/s定点数，超过范围时饱和。
- 融合有效位：`0/1`，表示该样本中IMU是否实际参与融合。
- 目标/实际中心速度：有符号0.1 mm/s定点数。
- 左右PWM：驱动端实际施加值的绝对计数，范围0–20000。
- LF04位型、纠偏和状态：低4位十进制输出、有符号整数`line_correction_mm_s`，以及`line_usable/line_recovering/line_pattern_invalid`三个标志。
- 正式融合诊断：任务进度、期望航向、路线前馈轮差、航向反馈轮差、LF04有效权重和最终轮差；纯LF04模式下新增融合字段保持为0。

`chassis_init()`会在每次上电初始化时清空 RAM。默认自检的架空五段和地面运动都会记录；未启用`F`调试时，等待页面和完全停车不写入，所以仍可利用等待页面产生的时间戳间隔区分运动段。五段架空、500 mm和双向90°的总运动时间远低于约60秒容量，不需要在地面连接电脑或发送 `C`。

UART驱动显式启用硬件FIFO，并把RX中断阈值设为1字节；`uart_try_read()` 在软件队列为空时还会直接轮询硬件RX FIFO，避免单字节RX中断未到达软件队列时丢失命令。单独发送一个ASCII `D`或`C`必须立即处理，不需要附加 `0`、连续字符或换行。TX每个字节在写入前后都等待UART `BUSY`清零，成功返回即表示该字节已经发送完成；任何超时都会立即终止本次CSV导出。

每次重新构建和烧录后，先保持12 V断开：静止完成IMU校准并停在 `LIFT+PRESS KEY`，通过COM3发送单个 `D`。空缓存也必须返回且只返回完整表头：

```text
time_ms,left_ticks,right_ticks,x_mm,y_mm,encoder_heading_deg,fused_heading_deg,imu_yaw_deg,fused_yaw_rate_dps,fusion_active,elapsed_ms,lap_total_ms,target_center_mm_s,actual_center_mm_s,left_pwm_count,right_pwm_count,line_bits,line_correction_mm_s,line_usable,line_recovering,line_pattern_invalid,mission_progress_mm,expected_heading_deg,route_feedforward_bias_mm_s,heading_feedback_bias_mm_s,line_weight_pct,final_steering_bias_mm_s
```

首次复验建议开启接收十六进制显示。空缓存表头必须恰好为435字节，以`74 69 6D 65 5F 6D 73`开头、以`5F 73 0D 0A`结尾；文本模式应显示上述完整27列表头。重复发送 `D`应重复得到同一结果。若无输出或出现 `~`、`}k`等乱码，不得接通12 V或重跑地面测试；保存第一次导出的原始十六进制，并测量PA10空闲电平及约`8.68 us/bit`的实际位宽。

### 无电机航向融合调试

1. 物理断开12 V，只保留5 V，正常开机并静止完成IMU校准，停在`LIFT+PRESS KEY`。
2. 发送`C`显式清空旧记录，再发送`F`；`F`不会自行清空RAM，也不会发送电机命令。
3. OLED显示`FUSION F/S STOP`。第二行`E/F`为编码器/融合航向，第三行`I/R`为原始IMU Yaw/融合角速度，第四行`IMU ON/OFF`和`N`表示融合有效性与记录数。
4. 从车顶向下顺时针手动转动约90°：原始`I`应为负变化，`F/R`应为正变化；反向转动时符号相反。轮子不计数时，保持静止后融合航向会按约1 s时间常数平滑回到编码器约束。
5. 发送`S`停止采样并返回`LIFT+PRESS KEY`，再发送`D`导出。采样期间`D/C`返回忙，中键和方向键都不会启动运动。

`F/f`只允许从`LIFT+PRESS KEY`进入，`S/s`只在融合采样页生效。任何运动入口、普通停车或急停都会防御性关闭空闲采样。右键开机进入的`UART DIAG STOP`仍把所有字节仅作为RX诊断，不执行`F/S/D/C`。

离线现场流程：

1. 保持独立5 V逻辑供电，按正常顺序完成IMU校准和架空五段自检。
2. 将车放到地面，在 `GROUND+PRESS KEY`、`PRESS FOR +90` 和 `PRESS FOR -90` 等待页面各停留数秒，再按中键执行500 mm、`+90°`和`-90°`并完成外部测量。
3. `TEST COMPLETE` 完全停车后先断开12 V，但持续保持5 V；不要复位、重新烧录或切换可能短暂掉电的电源。
4. 保持5 V将车搬回电脑旁。停车搬运不会新增记录，也不会改变已经存入RAM的样本。
5. 使用3.3 V TTL USB转串口，适配器RX接PA10/UART0 TX、TX接PA11/UART0 RX，并连接GND；适配器VCC悬空，不得反向给开发板供电。
6. 串口设为115200、8N1、无流控，先发送ASCII `D`并保存CSV。核对表头和数据行完整后，才允许发送ASCII `C`清空记录和溢出标志。

RAM是易失存储器。测试完成后若断开5 V、复位或重新烧录，尚未导出的数据无法恢复。不要在导出前发送 `C`。

UART0命令：

- 发送ASCII `D`：导出带表头CSV。
- 发送ASCII `C`：清空记录和溢出标志。
- 在`LIFT+PRESS KEY`发送ASCII `F`：开始无电机融合采样，不清空RAM。
- 在`FUSION F/S STOP`发送ASCII `S`：停止融合采样并返回等待页。

运动状态下不会执行导出或清空命令。分析时按时间戳间隔和左右轮运动特征分出架空五段、500 mm、`+90°`和`-90°`；分别比较`encoder_heading_deg`、`fused_heading_deg`和原始`imu_yaw_deg`。原始IMU Yaw与当前软件航向正号相反，比较时先乘以-1；融合航向应连续并接近外部实测角度。没有磁力计，因此长期打滑仍必须依靠外部角度基准判断。

## 测试与构建

PC主机测试覆盖：

- 16种AB转换、正反完整相位和非法跳变。
- 直线、原地旋转、圆弧和双航向里程计。
- 编码器–陀螺仪互补融合、符号转换、超时回退和恢复连续性。
- 加减速、三周期完成、堵转与急停。
- 左右速度滤波、换向PID复位。
- 遥测容量、溢出、52字节布局、累计航向、重复时间戳覆盖、27列CSV、六个正式融合字段、纠偏量正负/饱和、停止态10 Hz采样和运行中`BUSY`。
- 纯LF04和正式竞速全部16个位型的物理质心、单周期响应、普通22%/90 mm/s、B1/B8增强35%/120 mm/s、B0状态记忆与无限保持；正式融合另覆盖LF04与路线/航向同向叠加、反向LF04优先和分量遥测。
- 竞速A点零位快照、四赛段期望航向、拆分前馈/航向反馈、5919 mm距离门、DA段内355°–365°连续3周期锁存航向门和5982 mm锁停。
- 自检最终16字符格式，确保实时AB、CAL、MOVE和STATUS不会通过占位数字二次覆盖。

从仓库根目录运行全部29组 PC 主机测试（原底盘/竞速/滚球回归加H456任务、应用及遥测测试，需要 `gcc`）：

```text
powershell -NoProfile -ExecutionPolicy Bypass -File .\tests\run_host_tests.ps1
```

主机测试不能替代 ARMCC 全量构建、烧录或实车验收。

## H题第3小题杆球操作

独立杆球固件为`user/project_ball.uvprojx`，不初始化底盘；现场仍必须断开小车12 V电机电源。Maix和模型保持320×224，以32字节帧直接发送厘米位置，MSPM0只用厘米值控制并继续检查score≥0.20、valid、连续3帧和150 ms超时。当前Maix脚本仅在`X ±84%`、`Y ±20%` ROI内使用0.20低置信度阈值筛选目标，该值只用于本轮ROI限定调参。

当前`BALL_AUTO_CONTROL_MODE=BALL_AUTO_CONTROL_DISABLED`且`BALL_BALANCE_ALLOW_SEQUENCE=1`。正常上电先以1500 us安全初始化，再按2000 us/s斜率移动到1525 us水平零点并等待连续3帧有效视觉；显示`BALL READY C=GO`后把球放在O点并按PB24启动正式`O→+5 cm→-5 cm`串级序列。READY、闭环和重捕获恢复均以1525 us为零控制；运行中PB24立即中止并回到1500 us，本次上电不再重新启动。+5误差≤0.8 cm连续10 ms即折返，不检查速度；其巡航降为3.0 cm/s，停车距离门或2.5 cm固定接近区任一命中后，以`1.2×位置误差`连续降速并限制在3.0 cm/s。-5保持5 cm/s巡航、24 cm/s²制动估计和0.15 cm余量，进入2.0 cm接近区后采用`3×位置误差`并限制在4 cm/s。最终低速进入题面±1 cm即锁存捕获，捕获后目标速度为`3×位置误差-1×实际速度`并限制在±2 cm/s；捕获后连续500 ms满足±1 cm和≤1 cm/s即完成，随后普通带积分位置环继续向-5中心收敛。负端未捕获且仍在±1 cm外的100 ms进度门保持：先请求绝对1650 us最多150 ms，仍不动再用绝对1700 us最多350 ms；边界处朝目标速度达到0.5 cm/s即清零故障保持计时，位移达到0.15 cm并连续30 ms后释放，总静止故障门仍为500 ms。位置PID、速度PID、1300–1700 us绝对范围、5000 ms总门、视觉重捕获、PB24和26列遥测均不变。该版本按用户要求尚未回归、构建或实测。

正式序列成功启动时以10 ms周期写入600条、每条44字节的RAM记录，覆盖约6秒并导出26列CSV；`sequence_state`、`sequence_elapsed_ms`和`brake_active`分别记录序列阶段、总用时及独立制动状态，默认固件中`brake_active`应始终为0，总RAM占用不增加。`control_output_us`相对1525 us水平零点解释，`servo_target_us/current_us`仍为绝对脉宽。全部记录位于`0x20200000～0x20207fff`唯一32 KB SRAM内，重捕获期间不清空或结束会话。使用3.3 V TTL转串口：适配器RX接PA10、TX接PA11并共地，VCC悬空，串口为115200、8N1、无流控。达到5000 ms超时后立即冻结当时的实际舵机脉宽；目标与实际脉宽相等即结束遥测，OLED显示`BALL TIMEOUT`和非零`CSV Nxxx D=OUT`，此时可直接发送`D`导出，PB24只负责随后以原斜率回到1500 us。运行中PB24中止仍自动回中；正常完成后先在-5 cm稳定至少1秒，再按PB24回中。运行、重捕获、完成保持和回中期间会限频回复`BUSY`。`D`可重复，确认CSV完整后才发送`C`；断开5 V、复位或重新烧录都会丢失未导出记录。

当前固件在正式序列实际进入`TO_PLUS_5/TO_MINUS_5`时统一开始遥测。终态回中后第四行应显示非零`CSV Nxxx D=OUT`；`CSV EMPTY REBOOT`或串口`EMPTY`均表示RAM内没有可用数据，必须重新上电重跑，不得用空表头调参。显示数量应与`D`导出的数字数据行数一致；重复`D`不会清空，核验完成后才允许`C`。

OLED只在等待、失视重捕获和人工中止状态每100 ms更新；进入活动闭环前保留一帧`CAL SPEED PD`，运行中屏幕冻结属于预期行为。闭环数据应以UART0 CSV、杆上刻度和完整录像记录，不能因屏幕不变化判断程序卡死。供电/PWM、方向、视觉两点、速度环、中心闭环、`+5→-5`和连续5次验收的记录流程见[BALL_BALANCE_GUIDE.md](BALL_BALANCE_GUIDE.md)。

## H题第三题独立 Q3 工程（新方案）

新第三题固件使用 `user/project_ball_q3.uvprojx`，不要在旧 `project_ball.uvprojx` 上继续调参。新工程连接舵机、MaixCam、PB24 和 OLED，UART0只作为可选诊断/导出：PB27/TIMA1_CCP1 输出 50 Hz 舵机，UART2/PB15/PB16 接 MaixCam，PB2/PB3 为 OLED 软件 I²C，PB24 短按启动、运行中按下急停，PA10/PA11 的 UART0 为 115200 8N1 导出。OLED 只用于状态显示，闭环反馈仍只有 MaixCam。小车 12 V 电机、编码器、IMU 和 LF04 均不参与第三题。

上电先看OLED，不要求先接UART0。Q3专用OLED软件I²C使用5 us半周期（约100 kHz）；初始化时保持关屏，清完8页显存后才点亮，启动页再强制完整重绘一次，避免烧录/复位时显示旧显存或半屏。新OLED首屏固定为`Q3 TERRAIN CTRL / OLED PB2/PB3 / SERVO 1300-1700 / WAIT CORE`；随后第四行按启动阶段改显`CORE START`、`CORE UART2`、`CORE SERVO`、`CORE TIMG6`、`CORE SAFE`、`CORE OK`，core成功后立即强制整页刷新为真实等待页，再尝试初始化可选UART0。UART0可用时会输出`Q3 TERRAIN BOOT`和`Q3 CORE OK`；UART0不可用不影响OLED、Maix、舵机、PB24和正式运行。`Q3 PLACE BALL O`不是core卡死，而是等待视觉/O点条件；第三行会提示`NO VISION RX`、`BALL LOST`、`LOW SCORE`、`SLOW FRAME`、`VISION 1/3`、`VISION 2/3`或`MOVE TO O`，WAIT阶段慢帧仍可累计到3帧，UART0可用时发送`V`可导出一行视觉诊断和`diag=`分类。若核心初始化返回失败，会改显`Q3 CORE FAIL / STAGE UART2|SERVO|TIMG6|SAFE / ERR nn`并安全停机；若UART0可用，也会输出具体阶段和错误码。随后按WAIT、自动微调、READY、地图标定、正式阶段、救援/故障和CSV结果显示。非运动页面100 ms只写变化行；自动微调、地图扫描和正式运行中只允许阶段切换写第一行，避免软件I²C阻塞10 ms控制。

首次实车必须先生成地形表，仓库自带表仅用于安全首轮：球放O点并等`Q3 READY`，UART0发送`K`，OLED显示`MAP CAL ARMED`后按PB24确认。固件自动执行`O→+6→-6→O`，PB24全程可急停；结束自动输出`Q3_MAP_BEGIN...Q3_MAP_END`，`L`可重发。保存后运行`python tools/q3_fit_profile.py map.csv code/q3_ball_profile_generated.h`，全量Rebuild/Download。工具要求-6～+6 cm共13格都被正反方向观察，拒绝缺格、阈值错误和相邻脉宽异常跳变。机械、相机和连杆此后不得拆装，否则重新标定。

正常比赛上电时把球放O点。固件会在正式计时前自动小幅双向试探并主动回O，修正方向、零位和本次响应缩放；运动超过±1.2 cm或4.5 s无法回中显示`Q3 CAL FAULT`，第三行给出`WHY POS LIMIT`、`WHY PLUS DIR`、`WHY MINUS DIR`、`WHY RECENTER`或`WHY TIMEOUT`，UART0同步输出`REASON=... FROM=...`。只有`Q3 READY C=GO`允许按PB24正式启动。球进入+4.2～+5.8 cm即立即折返；负向接近仍以-4.7 cm为控制目标，但速度过大且预测停车点逼近`-3.2 cm`时会先切`MINUS_BRAKE`，在60–150 ms短失视窗口内继续保持制动，最终只在低速时进入捕获并改以-5.0 cm保持，捕获中若再次高速穿越会退回强制动，直到-5.8～-4.2 cm内且`|速度|≤1 cm/s`连续80 ms显示`Q3 PASS HOLD`；若已进入最后120 ms窗口，则满足终点低速条件可立即收口。卡住180 ms且真实进展不足0.12 cm时按“本格短脉冲→反摇50 ms/最多0.25 cm→目标方向安全边界160 ms”救援，最多两轮；最终合法带内禁用脱困。全部绝对脉宽仍为1300～1700 us。

视觉年龄达到60 ms会取消极限救援并回局部平衡，150 ms仍无有效帧才锁存故障；5000 ms总门和运行中PB24急停均回1500 us安全中位。PASS后先观察保持，再按PB24回中。最后120 ms窗口内不再继续加重末窗助力，但会保留终点确认余量；负端短失视期间只要仍有高速过冲风险就继续刹车，不会立刻回到平衡脉宽。UART0的`V`只读视觉诊断，`D/C`导出/清空512条×40字节、10 ms周期、22列正式CSV；`K/L`负责地图标定/导出，`A/W`选择地形/备用波形模式，所有UART命令都不能启动运动。至少完成三轮地图一致性、十次冷启动微调和十次正式动作，逐轮保存CSV与Maix视频；未完成Rebuild、Map内存检查和实车十连测前不得声明通过第三题。

## H题第五题

第五题相关流程现在并入 `user/project_h456.uvprojx`，不再保留独立 `user/project_h5.uvprojx`。对应的烧录后检查、H5/H6 参数和整圈验收请直接看下面的 H4/H5/H6 联合流程。

## H题第4/5/6联合固件烧录后流程

工程为`user/project_h456.uvprojx`。Rebuild必须显示`0 Error(s), 0 Warning(s)`；首次还要在Map确认唯一`RW_IRAM2`不超过`0x8000`，只有26,400字节的`h456`联合记录区，旧底盘遥测容量为1，且不存在`ball_telemetry`记录数组。烧录后严格按以下顺序，不要直接落地跑整圈：

1. **断12 V静态检查。** 架空车轮并断开电机12 V，只保留MSPM0 5 V、MaixCam和独立舵机电源，共地上电。OLED应先短暂显示`H456 BOOT`；若后续模块初始化失败，会停在`H456 INIT FAIL`并显示`STATUS xx`，此时表示OLED本身已工作，应优先检查IMU/LF04/底盘/滚球初始化；若第四行显示`LINE CFG FAIL`，优先检查本轮线控配置参数而不是接线。若连`H456 BOOT`都不出现，才优先检查OLED供电、PB2/PB3和I2C接线。联合固件默认进入H6；车辆放白底并保持IMU静止，H456专用IMU校准约需1.5秒，移动或震动仍会清零重来。舵机应先在1500 us安全初始化；Maix有效且H6球位在±12.5 cm内后，MSPM0会先把当前球位设为临时保持目标再开启闭环，电机不得动作。
2. **等待三类准备门。** OLED先显示`H456 CALIBRATE`，第四行`WAIT READY SAFE`表示正常等待且电机保持安全停止，不是故障锁停；IMU完成且LF04白底原始`RF`连续10个20 ms样本后进入`H6 BALL SETUP`。第四行会按实际缺口显示`WAIT VISION`、`WAIT CTRL ACTIVE`、`WAIT POS <=0.8`、`WAIT <=12.5CM`、`WAIT SPD <=1.0`或`SETTLE 500MS`，分别检查Maix有效帧、滚球闭环、H4/H5目标误差、H6可锁定范围、速度抖动和500 ms稳定计时。H4/H5把球放到显示目标附近，保持误差≤0.8 cm且速度≤1 cm/s连续500 ms；H6把球放到任意指定位置，位置必须在±12.5 cm内且速度≤1 cm/s连续500 ms，页面应变为`H6 READY`并显示`AUTO LOCK PB24`。
3. **核对启动武装和方向键。** 若READY后OLED第四行显示`REL PB24`，先完全松开PB24；只有显示`C=GO U/D=MODE`后，再按PB24才会锁定目标并启动。READY前后分别按上/下切换H6→H4→H5和反向循环；H4/H5第二行目标必须为0。H6左/右键不再改变目标，当前球位会作为READY前临时候选目标，PB24启动瞬间才锁定为整圈评分目标。全过程方向键不得启动运动，车轮不得收到运动命令。
4. **核对滚球方向和安全回中。** 在断12 V状态选择H4、目标0 cm，观察球能在±0.8 cm门内稳定且舵机无撞限。出现视觉丢失或人为把球持续移到目标2 cm外时，固件应锁停并把舵机回到1500 us；若未回中、发生机械干涉或显示故障反复复位，立即断舵机电源并停止。
5. **架空启动与中键急停。** 重新上电恢复READY，架空两轮后接通12 V。H6可使用`maixcam/h6_maix.py`，但该脚本仍只发送当前球位置，屏幕上的`H6 MSP LOCK PB24`表示锁定由MSPM0在PB24边沿完成，不需要也不得新增PB24到Maix的接线。确认OLED不是`REL PB24`后按PB24一次，左右轮应按顺时针路线方向同向起步，OLED在RUN期间保持最后一帧；H4启动后前6000 ms叠加`+60 us`到0的短时滚球控制偏置，H5为`+100 us`到0、持续6000 ms。H6按锁定目标分档：`target_cm>=+8 cm`为`+190 us/5000 ms`，`+3 cm<=target_cm<+8 cm`为`+160 us/3000 ms`，`-3 cm<target_cm<+3 cm`为`+60 us/3000 ms`，`-8 cm<target_cm<=-3 cm`为`+60 us/5000 ms`，`target_cm<=-8 cm`为`+80 us/6000 ms`。这些补偿都不是目标点偏移，H6的`target_cm`在PB24瞬间锁定，误差、安全门和评分CSV均按该锁定值计算；当前滚球闭环已含位置P/D/I和速度P/D，负侧本轮只做补偿降档，不改全局控制限幅、舵机范围、PID或底盘速度。100～300 ms内再按PB24，必须立即锁停两轮并回1500 us。方向错误、编码器BAD增长、约160 ms堵转保护无效或中键不能锁停时禁止落地。
6. **H4低风险首跑。** 重新上电，把车放A点、车头对准AB顺时针方向，白底校准后再放到黑线位置；选择H4并等到READY，只按PB24启动。车辆前1200 ms以100 mm/s²柔起步，之后恢复150 mm/s²并升到220 mm/s，理论约7.84 s通过B；通过1500 mm后继续循迹平滑停车，不执行终点回正。H4直线段会使用更温和的LF04纠偏，并在融合航向偏离启动方向达到6°时临时进入航向优先修正，回到3°以内再恢复LF04融合。测试员全程手扶急停开关旁，偏离黑线、球误差持续增大或机械异常立即按PB24。
7. **读取H4结果。** 正常停稳后页面显示`H4 PASS/FAIL`、冻结用时和`BALL MAX`。评分时间应≤8.0 s；滚球评分前误差达到±1.20 cm会立即FAIL，±1.00～±1.20 cm之间需连续超过500 ms才FAIL。`BALL MAX`和CSV的`maximum_ball_error_cm`仍保留真实最大误差，所以可能出现`maximum_ball_error_cm > 1.0`但`ball_score_passed=1`，表示只出现短时/轻微边界超限。此时闭环继续保持0 cm；按PB24后才回1500 us，等待`CSV Nxxx D=OUT`。
8. **导出每一轮CSV。** 先断12 V但保持5 V，不复位；串口115200、8N1、无流控，只发送一次`D`。保存35列CSV并核对H4约20 ms间隔、H5/H6约60 ms间隔、记录数不超过600、终态快照存在；新增`expected_heading_deg`、`heading_error_deg`、`heading_gate_met`用于判断A点航向门，`raw_x_px`保留用于对照Maix横向像素，`score_elapsed_ms`是最终锁存结果而不是逐行实时计时。调参前先检查每行必须35列、`time_ms`单调、舵机值在1300-1700 us合理范围；字段缺失、粘行或明显不可能的舵机/速度值属于串口或粘贴坏行，不参与最大误差计算。重复`D`应一致。确认文件完整后才发`C`，随后断电重启下一轮。
9. **H4至少三轮。** 三轮均确认AB≤8 s、循迹停车、PB24急停、最大球误差和CSV正常后，才开展H5。任一轮滚球FAIL都先看区间最小/最大误差、视觉年龄、舵机、LF04数据和`fused_heading_deg`；H4到B点若仍出现十几度以上偏航，应先排查LF04安装、A点摆车和地面黑线，而不是直接提高PWM或扩大1300–1700 us范围。
10. **H5整圈。** 目标固定0 cm；按同一A点和车头基准启动。H5/H6这组正式模式默认按210 mm/s巡航和120 mm/s²加减速运行，并在前1200 ms采用100 mm/s²软启动，从约5580 mm开始允许A点航向门计数。H5/H6的LF04弯道线控使用普通20%/70 mm/s、外侧单探头22%/60 mm/s、B0曲线保持16%/50 mm/s，并在曲线退出时加入120 ms渐退窗，优先降低BC/DA弯道滚球横向冲击。CD第二直线中前段3200-4200 mm会临时把航向反馈限到0.16 rad/s，并限制最终轮差每20 ms最多变化8 mm/s，用于压住BC出弯后的短时滚球越界；窗口外自动恢复当前控制。程序只在进度≥5932 mm且累计航向连续3周期处于355°～365°时冻结通过A时间，30 s内合格；之后依LF04平滑停车，不做第2问回正。到5982 mm仍缺航向门会`LAP FAULT`并回1500 us。
11. **H6任意位置锁定测试。** H5通过后，H6先测`-5 cm`附近3次，再测`-3 cm`和`-6 cm`；通过后再按`-9 cm`、`0 cm`、`+6 cm`、`+9 cm`顺序测试，每点至少3次。每次移动球后必须重新等500 ms READY。按PB24时MSPM0锁定当时Maix厘米位置，CSV的`ball_target_cm`应等于锁定值附近，验收仍是30 s内通过A且全过程误差相对锁定目标不超过±1 cm。重点看`0–1500 mm`段最大误差、`ball_violation`是否始终为0、`maximum_ball_error_cm`是否压到0.85 cm附近、舵机是否没有持续顶到1300/1700 us。若`-5 cm`仍在0.9 cm附近，再考虑H6负侧专用PID或速度阻尼；当前先不新增PID。

正常完成时滚球保持目标，必须按PB24后才回1500 us并开放导出；视觉超时、脱困故障、底盘堵转、LF04 IO故障、连续100 ms超过±2 cm或运行中PB24都会直接锁停并自动回中。任何故障轮都保留5 V先导出CSV，禁止复位后再找数据。

Keil完整构建：

```text
D:\Keil_v5\UV4\UV4.exe -b user\project.uvprojx -j0
```

提交和烧录基线为 `0 Error(s), 0 Warning(s)`。算法能提高分辨率和重复性，但无法消除轮胎打滑、减速箱回差、轮径变化和地面差异。

## 顺时针胶囊赛道竞速任务

竞速入口位于`user/project_track.uvprojx`，默认`user/project.uvprojx`仍是安全自检。竞速配置使用PID输出`±14000`、积分`±7000`和前馈6000，底层最终饱和在`±20000`；最大轮速500 mm/s、160 ms堵转和中键锁定急停均不变。

### 纯LF04循迹诊断

1. 仍烧录`project_track.uvprojx`，上电前按住上键；车辆先放白底并保持静止，等待白底稳定门和IMU校准完成，再完全松开上键。普通开机不按上键仍进入整圈竞速。
2. `LF ONLY READY`页用上/下键选60、120、200、280或350 mm/s，默认60。方向键仅在READY页生效，运行中不会切速或启动。
3. 准备好后直接按中键启动；READY页不检查当前B0-B15位型。若从B0启动且尚无有效样本，四路误差按0处理并直行。中键仍是唯一启动键，运行中按下会锁定急停。
4. 模式只用LF04决定左右轮差速；编码器继续执行轮速PID、累计里程和约160 ms堵转保护，IMU只写入遥测而不参与转向。目标速度以400 mm/s²升降，不再设置自动停车距离，可连续运行完整一圈。
5. `B0`不改变当前任务速度，持续复用最后有效四路误差，直到任意探头重新识别黑线；不会因持续时间锁停。所有`B1-B15`均按物理质心计算，B1/B8及其后的B0保持35%/120 mm/s外侧增强；新有效位型经两周期反向确认后立即接管，不再等待请求行程门。B0期间高速保持仍可能持续偏离赛道，测试人员必须随时准备按中键或断12 V。
6. 回到起点后按中键执行锁定急停；固件结束遥测会话并写入`line_correction_mm_s=0`的最终快照。保持5 V并发送单个`D`导出27列CSV，确认后才可发送`C`；随后断电重启并重新进入纯LF04模式。纯LF04的六个正式融合新增列应为0。依次按60→120→200→280→350 mm/s验证，先短距离确认方向，再逐级完成整圈；任一档出现堵转、振荡或完全脱线都停止升级。

RAM遥测约保存前60秒且缓冲满后不覆盖。60 mm/s跑完整圈约需102秒，因此该档CSV可能只含前60秒，但缓冲满不会停止车辆；120 mm/s及以上的标称整圈时间在容量范围内。

默认自检工程的开机右键UART安全诊断入口没有改变；纯LF04入口只存在于竞速工程且只使用开机上键选择。

正式竞速上电时不要按住上键。把车辆放在白底且保持静止；LF04固定采用白底高、黑线低逻辑，不再自适应记录开机极性；原始`RF`必须连续稳定10个20 ms样本，并与IMU校准同时完成，才会出现`RACE FUSION`。若显示`LF ONLY READY`，说明误进纯LF04诊断模式，必须断电后不按上键重启。IMU已完成但白底未稳定时显示`LF WHITE WAIT`、当前原始位型和稳定计数，电机保持锁定。进入READY后再把车移到A点、车头对准AB顺时针方向；程序不识别A点，当前LF04位型也不参与启动许可。按中键会把当前编码器里程和融合航向定义为竞速零点并立即启动，状态依次为AB、BC、CD、DA和终点低速检查。

路线长度为`2×1500+2π×500=6141.6 mm`。默认stage 0直线/弯道均为360 mm/s，中心速度以400 mm/s²变化；stage 1/2保留为未启用的可选档，仅把直线依次提高到380/400 mm/s，弯道保持360 mm/s。终点层按剩余制动距离计算速度上限，保证双门前达到100 mm/s，LF04恢复层只能进一步降速，不能把终点请求抬回200 mm/s。编码器里程生成连续期望航向：AB为0°，BC从0°升至180°，CD为180°，DA从180°升至360°。AB/CD角速度前馈为0，BC/DA为`+v/500`；360 mm/s弯道前馈为0.72 rad/s。期望航向与融合航向误差使用`Kp=4.0`和`±0.35 rad/s`限幅修正，底盘速度模式继续执行融合角速度反馈。

理论路线长6141.6 mm继续用于AB/BC/CD/DA、R500前馈和期望航向，不再作为停车坐标。完成白底和IMU校准后，把车尾约定测试点放在A线、车头对准AB；READY页不检查LF04位型，按中键以当前编码器和融合航向建立零点，并锁存该融合方位作为物理起点方向参考。首轮车尾终点参考为`finish_reference_progress_mm=5932 mm`。航向门从DA起点约4570.8 mm开始允许计数，融合顺时针航向连续3个20 ms周期进入355°–365°即锁存，锁存后升到389°或390°也不会清除。终点从`5932-190=5742 mm`开始减速；编码器里程达到`5932-13=5919 mm`且航向门已经锁存时制动，单门满足不得制动。到`5932+50=5982 mm`仍未同时满足会立即停车并显示`FAULT LAP CHECK`。首次两轮连续3周期低于20 mm/s后进入`ALIGN TO START`：终点专用`finish_alignment_heading_bias_deg=+37°`补偿一圈后的累计航向偏差，误差按`wrap(start+37°-current)`计算，正值为顺时针；LF04权重强制为0。巡线航向保持`Kp=4.0`，回正独立使用`Kp=2.0`。补偿误差首次进入±1°（当前启动零点下396°–398°）立即锁存停车，双轮停稳前不因航向离窗反向；连续3周期低于20 mm/s后以±2°（395°–399°）验收，超出才从静止重新微调。主动回正3秒内未捕获会锁停；截止前已捕获时最多保留300 ms无动力停稳宽限。最新故障CSV中391.9°–402.2°的反复换向由该停稳锁存消除。初始误差超过45°或宽限结束仍未停稳/超差显示`FAULT ALIGN`；`EST ERR`按最终停稳进度减5932 mm计算。360°仍只负责完整圈门和路线语义，A点横线及任何LF04位型都不参与停车判定。

正常完成页第四行不再使用容易误解的`ENC+IMU PASS/FAIL`。20秒和编码器估算±20 mm均合格时显示`LAP CHECK PASS`；仅时间超限显示`TIME LIMIT FAIL`，仅估算位置超限显示`EST POS FAIL`，两项均超限显示`TIME+POS FAIL`。例如最新18.90秒、估算`+21 mm`的一圈应显示`EST POS FAIL`，但CSV的`fusion_active=1`仍表示IMU正常参与融合。

`+37°`来自前一圈首停累计航向约387°以及外部观察到的约10°左偏：旧逻辑回到360°会额外向左转约28°，新目标约397°则从首停位置向右修正。连续3圈完全停稳后，以向右/顺时针为正记录物理角度误差；若误差方向交替或三圈极差超过3°，保持+37°并优先检查轮胎打滑、地面和机械间隙。只有三圈始终同向且平均绝对误差超过1°，才按`新偏置=旧偏置-平均有符号角度误差`校准。该偏置不得用于修改巡线融合、路线前馈或`effective_track_mm`。

`finish_stop_lead_mm=13 mm`对应100 mm/s低速制动；`finish_reference_progress_mm=5932 mm`由上一轮5994 mm参考、50 mm故障超程、约13 mm滑行和本次车尾越线125 mm估算。至少完成3圈后，以同一个车尾测试点越过A线为正记录外部有符号误差，并按`新终点参考=旧终点参考-平均有符号误差`修正终点参考。只有CSV显示实际滑行距离不符时才调整13 mm提前量，不得用巡线PID或路线前馈修正固定停车偏差。

LF04从左到右为PA31/PA12/PB8/PA27，物理中心位置为`-40.25/-7.25/+7.25/+40.25 mm`。所有低电平探头参与质心平均，归一化误差为`-average(position)/40.25`；左侧为正、右侧为负，B6/B9/B15为0。所有`B1-B15`均有效，只有`B0`表示丢线。控制器每20 ms响应，使用`Kp=1.2、Ki=0、Kd=0.20`的PD，PID输出限制`±1`且不使用I项、中心死区、全局低通或轮差斜坡。普通位型使用22%纠偏和90 mm/s总偏置上限，B1/B8最外侧单探头立即使用35%和120 mm/s。直接左右反向首周期有效误差为0，连续第二周期或随后B0确认；居中与同侧变化立即接受。纯LF04和正式竞速的B0都无限保持最后确认误差和增强状态；首次B0按居中误差且不增强处理。

三类传感器按职责仲裁：编码器生成里程、赛段和R500路线前馈，编码器+IMU互补融合生成航向误差与角速度阻尼，LF04提供直接横向回线方向。正式竞速恢复`22d672e`已验证的LF04方向优先规则：LF04纠偏非零时，同向路线前馈和航向反馈可以叠加到当前位型上限，反向路线量直接丢弃，不得抵消或反转LF04；LF04质心为0时路线与航向正常接管。B0继续保持最后确认的LF04方向，IMU失效时融合层无跳变退化为编码器。中键急停、堵转、500 mm/s轮速和PWM 20000硬限制始终高于三者。

通用GPIO输入初始化会先关闭输出使能，竞速初始化、READY到RUN的启动边沿和每次20 ms读取前还会重新配置四路上拉输入。RUN页第四行每秒交替显示`Rr Ww Bb`和`LFb Ln DnHn`：`R/W/B`依次为原始GPIO、固定白底期望和归一化黑线位，`L`为B0保持状态，`D/H`为距离门和航向门。正常白底必须显示`RF WF B0`；从左到右逐路覆盖时原始值为`RE/RD/RB/R7`，归一化位依次为`B1/B2/B4/B8`。输入重申失败显示`LF GPIO FAULT`；B0只累计并显示保持时间，不会触发`LF LOST STOP`。电机运行时四块LF04的检测指示灯可能微亮，不能据此判定GPIO持续低电平，必须以OLED原始/归一化位型为准。

竞速和纯LF04模式都按有效中键边沿启动遥测会话，`elapsed_ms`以该边沿为零点；竞速`lap_total_ms`取启动到回正后最终停稳，纯LF04取启动到中键锁停。CSV共27列，`line_correction_mm_s`仍为原始有符号LF04分量；末六列依次记录任务进度、期望航向、路线前馈轮差、航向反馈轮差、LF04权重百分比和最终轮差。正式竞速巡线时`line_weight_pct`为100，原地回正时为0；纯LF04模式中六个正式融合列为0。恒定350 mm/s、越过6141.6 mm且最后人工中键停车的数据属于纯LF04诊断；默认stage 0正式融合的任务速度为360 mm/s并使用终点双门。`line_usable,line_recovering,line_pattern_invalid`保持兼容含义：B1-B15时`line_usable=1`，B0时`line_recovering=1`，兼容列`line_pattern_invalid`固定为0。运行、制动和回正期间`D/C`不导出、不清空，每秒最多回复一次短`BUSY`；完全停车后保持5 V、断开12 V，SSCOM关闭方向标记、时间标签、定时发送和自动换行，只发一次ASCII `D`或十六进制`44`并等待完整导出；串口工具显示的“发→/收←”和时间标签不是固件内容，不能保存进CSV。

杆球第三题当前控制基线：Maix分段`FIXCM`为唯一厘米输入；正向3.0 cm/s巡航、18 cm/s²制动估计、2.5 cm固定接近区和1.2倍位置参考；负向接近为3倍位置参考，最终捕获只允许低速进入并以-5.0 cm保持，捕获中高速穿越会退回强制动。正式序列脱困启动前速度绝对值必须≤1 cm/s。
