chushengzhink/2026tibei-mspm0g3507-icm42688/tmp/pdfs/h_problem-3.png

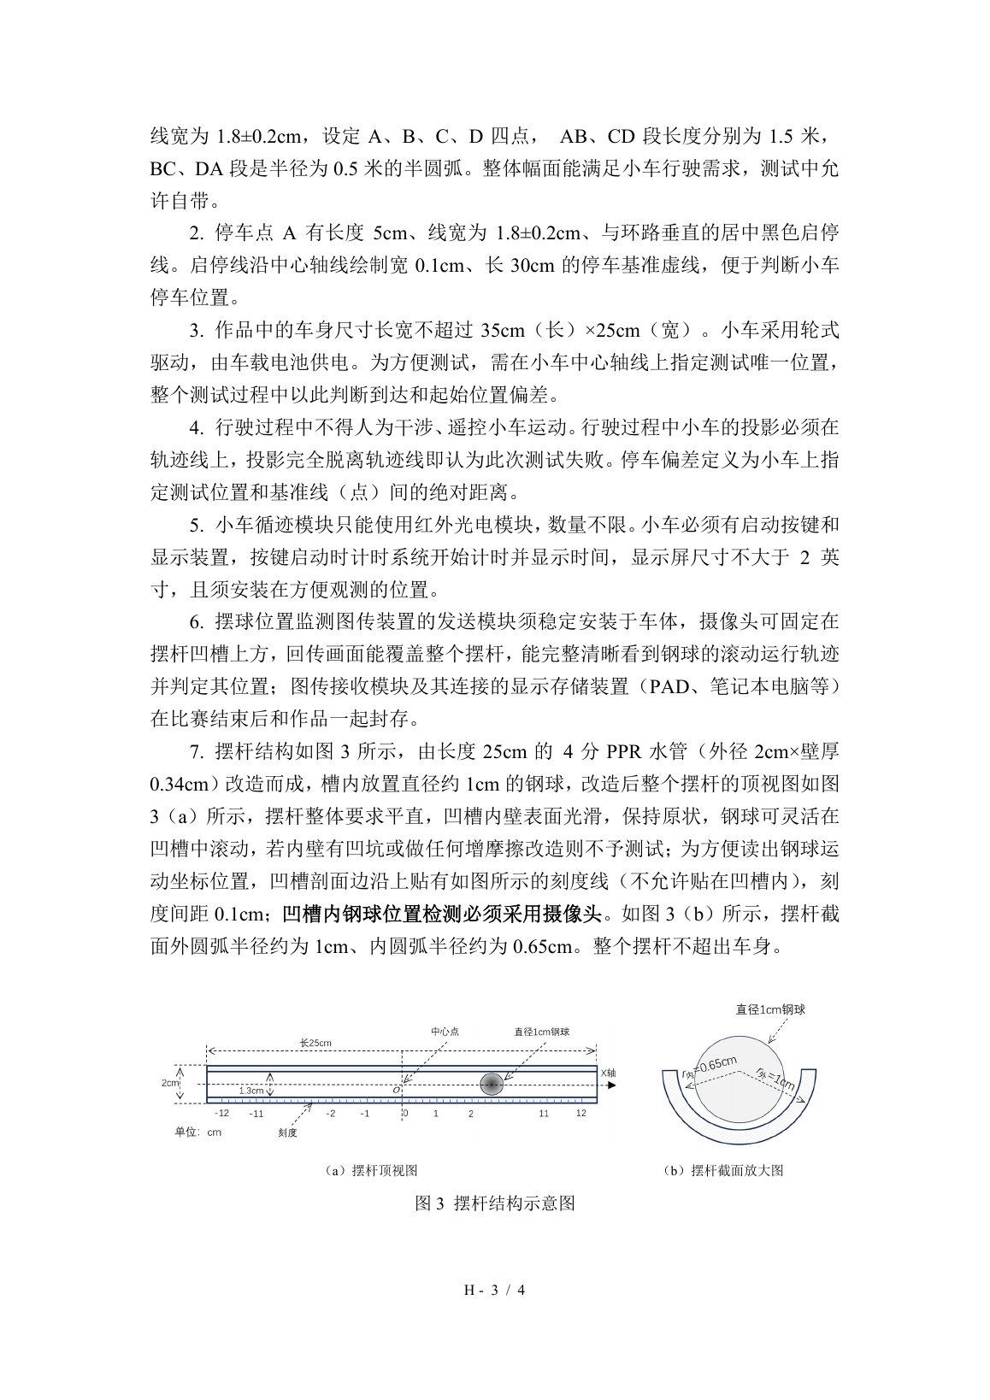
tmp/pdfs/h_problem-3.png
