chushengzhink/2026tibei-mspm0g3507-icm42688/tmp/pdfs/h_problem/page-2.png

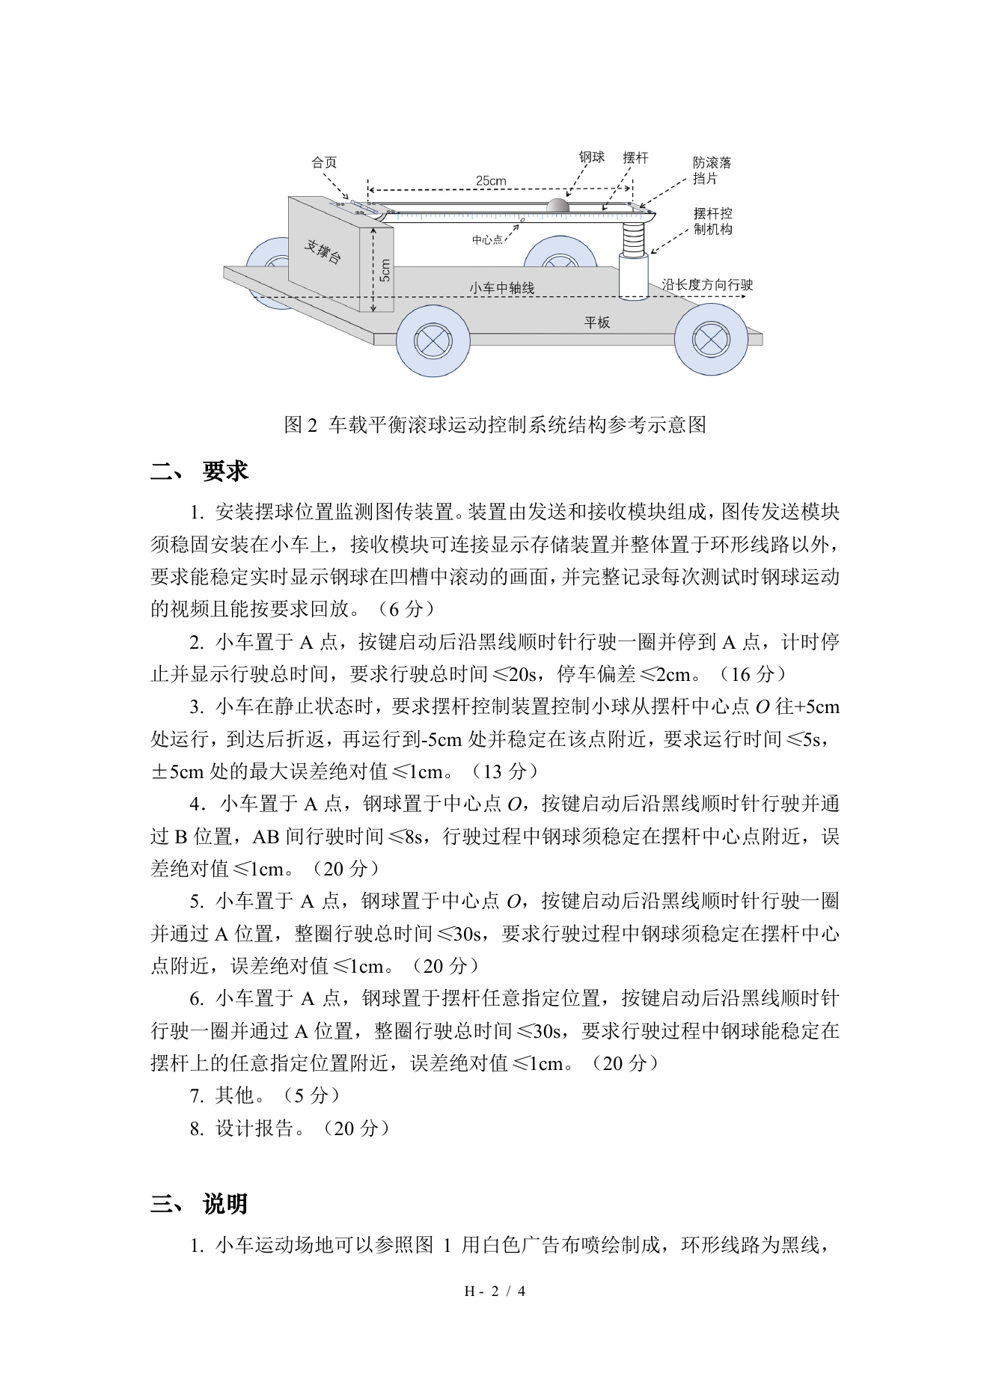
tmp/pdfs/h_problem/page-2.png
