chushengzhink/2026tibei-mspm0g3507-icm42688/code/chassis_track_line_control.c

#include "chassis_track_line_control.h"

#include <float.h>

#define LINE_CONTROL_OUTER_POSITION_QUARTER_MM (161)

static const int16_t g_line_sensor_positions_quarter_mm[4] = {
    -161, -29, 29, 161
};

const chassis_track_line_control_config_t
    g_chassis_track_line_control_default_config = {
        214.2f,
        500.0f,
        90.0f,
        0.22f,
        120.0f,
        0.35f,
        110.0f,
        0.31f,
        1200.0f,
        1.2f,
        0.0f,
        0.20f,
        1.0f,
        0.0f,
        20U,
        600U,
        600U,
        2U,
        5U,
        0U,
        false
    };

const chassis_track_line_control_config_t
    g_chassis_track_line_control_line_only_config = {
        214.2f,
        500.0f,
        90.0f,
        0.22f,
        120.0f,
        0.35f,
        110.0f,
        0.31f,
        1200.0f,
        1.2f,
        0.0f,
        0.20f,
        1.0f,
        0.0f,
        20U,
        600U,
        600U,
        2U,
        5U,
        0U,
        false
    };

static bool line_control_float_valid(float value)
{
    return (value == value) && (value <= FLT_MAX) &&
        (value >= -FLT_MAX);
}

static float line_control_abs(float value)
{
    return value < 0.0f ? -value : value;
}

static float line_control_min(float left, float right)
{
    return left < right ? left : right;
}

static bool line_control_config_valid(
    const chassis_track_line_control_config_t *config)
{
    return (config != 0) &&
        line_control_float_valid(config->effective_track_mm) &&
        line_control_float_valid(config->maximum_wheel_speed_mm_s) &&
        line_control_float_valid(config->maximum_correction_mm_s) &&
        line_control_float_valid(config->correction_ratio) &&
        line_control_float_valid(
            config->outer_single_maximum_correction_mm_s) &&
        line_control_float_valid(
            config->outer_single_correction_ratio) &&
        line_control_float_valid(
            config->curve_hold_maximum_correction_mm_s) &&
        line_control_float_valid(
            config->curve_hold_correction_ratio) &&
        line_control_float_valid(
            config->curve_exit_minimum_travel_mm) &&
        line_control_float_valid(config->kp) &&
        line_control_float_valid(config->ki) &&
        line_control_float_valid(config->kd) &&
        line_control_float_valid(config->pid_output_limit) &&
        line_control_float_valid(config->pid_integral_limit) &&
        (config->effective_track_mm > 0.0f) &&
        (config->maximum_wheel_speed_mm_s > 0.0f) &&
        (config->maximum_correction_mm_s > 0.0f) &&
        (config->maximum_correction_mm_s <=
         config->maximum_wheel_speed_mm_s) &&
        (config->correction_ratio > 0.0f) &&
        (config->correction_ratio <= 1.0f) &&
        (config->outer_single_maximum_correction_mm_s > 0.0f) &&
        (config->outer_single_maximum_correction_mm_s <=
         config->maximum_wheel_speed_mm_s) &&
        (config->outer_single_correction_ratio > 0.0f) &&
        (config->outer_single_correction_ratio <= 1.0f) &&
        (config->curve_hold_maximum_correction_mm_s > 0.0f) &&
        (config->curve_hold_maximum_correction_mm_s <=
         config->outer_single_maximum_correction_mm_s) &&
        (config->curve_hold_correction_ratio > 0.0f) &&
        (config->curve_hold_correction_ratio <=
         config->outer_single_correction_ratio) &&
        (config->curve_exit_minimum_travel_mm > 0.0f) &&
        (config->kp > 0.0f) &&
        (config->ki >= 0.0f) &&
        (config->kd >= 0.0f) &&
        (config->pid_output_limit > 0.0f) &&
        (config->pid_output_limit <= 1.0f) &&
        (config->pid_integral_limit >= 0.0f) &&
        (config->pid_integral_limit <= config->pid_output_limit) &&
        (config->control_period_ms > 0U) &&
        (config->outer_lost_full_boost_ms > 0U) &&
        (config->outer_lost_taper_ms > 0U) &&
        (config->reverse_confirm_cycles > 0U) &&
        (config->curve_exit_confirm_cycles > 0U);
}

static bool line_control_centroid_error(
    uint8_t black_bits, float *error)
{
    int16_t position_sum = 0;
    uint8_t active_count = 0U;
    uint8_t index;

    for (index = 0U; index < 4U; ++index) {
        if ((black_bits & (uint8_t) (1U << index)) != 0U) {
            position_sum = (int16_t) (position_sum +
                g_line_sensor_positions_quarter_mm[index]);
            ++active_count;
        }
    }
    if (active_count == 0U) {
        return false;
    }
    *error = -(float) position_sum /
        ((float) active_count *
         (float) LINE_CONTROL_OUTER_POSITION_QUARTER_MM);
    return true;
}

static chassis_track_line_state_t line_control_classify(
    bool line_valid, float error)
{
    if (!line_valid) {
        return CHASSIS_TRACK_LINE_LOST;
    }
    if (error > 0.0f) {
        return CHASSIS_TRACK_LINE_LEFT;
    }
    if (error < 0.0f) {
        return CHASSIS_TRACK_LINE_RIGHT;
    }
    return CHASSIS_TRACK_LINE_CENTERED;
}

static int8_t line_control_error_side(float error)
{
    if (error > 0.0f) {
        return 1;
    }
    if (error < 0.0f) {
        return -1;
    }
    return 0;
}

static void line_control_clear_pending(
    chassis_track_line_control_t *control)
{
    control->pending_line_error = 0.0f;
    control->pending_side = 0;
    control->pending_cycles = 0U;
}

static bool line_control_filter_error(
    chassis_track_line_control_t *control, bool line_valid,
    float raw_error, float *filtered_error)
{
    int8_t raw_side;
    bool first_valid = false;

    if (!line_valid) {
        if (control->pending_cycles != 0U) {
            if (control->pending_cycles < UINT8_MAX) {
                ++control->pending_cycles;
            }
            if (control->pending_cycles >=
                control->config.reverse_confirm_cycles) {
                control->last_line_error =
                    control->pending_line_error;
                control->accepted_side = control->pending_side;
                line_control_clear_pending(control);
            }
        }
        *filtered_error = control->last_line_error;
        return false;
    }

    raw_side = line_control_error_side(raw_error);
    if (!control->has_valid_error) {
        first_valid = true;
        control->has_valid_error = true;
        control->last_line_error = raw_error;
        control->accepted_side = raw_side;
        line_control_clear_pending(control);
    } else if (raw_side == 0) {
        control->last_line_error = 0.0f;
        control->accepted_side = 0;
        line_control_clear_pending(control);
    } else if ((control->accepted_side == 0) ||
               (raw_side == control->accepted_side)) {
        control->last_line_error = raw_error;
        control->accepted_side = raw_side;
        line_control_clear_pending(control);
    } else {
        if (raw_side != control->pending_side) {
            control->pending_side = raw_side;
            control->pending_line_error = raw_error;
            control->pending_cycles = 1U;
        } else if (control->pending_cycles < UINT8_MAX) {
            ++control->pending_cycles;
        }
        if (control->pending_cycles >=
            control->config.reverse_confirm_cycles) {
            control->last_line_error = raw_error;
            control->accepted_side = raw_side;
            line_control_clear_pending(control);
        } else {
            control->last_line_error = 0.0f;
        }
    }
    *filtered_error = control->last_line_error;
    return first_valid;
}

static float line_control_correction(
    const chassis_track_line_control_t *control,
    float pid_output, float linear_mm_s, bool outer_single_boost)
{
    float correction_ratio = outer_single_boost ?
        control->config.outer_single_correction_ratio :
        control->config.correction_ratio;
    float maximum_correction_mm_s = outer_single_boost ?
        control->config.outer_single_maximum_correction_mm_s :
        control->config.maximum_correction_mm_s;
    float magnitude = line_control_min(
        linear_mm_s * correction_ratio,
        maximum_correction_mm_s);

    return pid_output * magnitude;
}

static bool line_control_outer_single(uint8_t black_bits)
{
    return (black_bits == 0x01U) || (black_bits == 0x08U);
}

static float line_control_limit_signed(float value, float limit)
{
    if (value > limit) {
        return limit;
    }
    if (value < -limit) {
        return -limit;
    }
    return value;
}

static float line_control_curve_hold_magnitude(
    const chassis_track_line_control_t *control, float linear_mm_s)
{
    return line_control_min(
        linear_mm_s * control->config.curve_hold_correction_ratio,
        control->config.curve_hold_maximum_correction_mm_s);
}

static void line_control_clear_curve_memory(
    chassis_track_line_control_t *control)
{
    control->curve_memory_side = 0;
    control->curve_travel_mm = 0.0f;
    control->curve_exit_cycles = 0U;
}

static void line_control_clear_curve_exit_fade(
    chassis_track_line_control_t *control)
{
    control->curve_exit_fade_remaining_ms = 0U;
    control->curve_exit_fade_start_final_bias_mm_s = 0.0f;
}

static void line_control_accumulate_curve_travel(
    chassis_track_line_control_t *control, float linear_mm_s)
{
    float remaining_mm;
    float step_mm;

    if (control->curve_travel_mm >=
        control->config.curve_exit_minimum_travel_mm) {
        return;
    }
    remaining_mm = control->config.curve_exit_minimum_travel_mm -
        control->curve_travel_mm;
    step_mm = linear_mm_s *
        (float) control->config.control_period_ms / 1000.0f;
    control->curve_travel_mm += step_mm < remaining_mm ?
        step_mm : remaining_mm;
}

static void line_control_update_curve_memory(
    chassis_track_line_control_t *control, const line_sample_t *sample,
    bool line_valid, bool suppress_reversal, float linear_mm_s)
{
    int8_t opposite_side;
    int8_t side;

    if (!control->config.curve_memory_enabled) {
        return;
    }
    side = control->accepted_side;
    if (control->curve_memory_side != 0) {
        line_control_accumulate_curve_travel(control, linear_mm_s);
        if (line_valid && (sample->black_bits == 0x0FU)) {
            line_control_clear_curve_memory(control);
            return;
        }
        opposite_side = (int8_t) -control->curve_memory_side;
        if (!suppress_reversal && line_valid &&
            !line_control_outer_single(sample->black_bits) &&
            (side == opposite_side) &&
            (control->curve_travel_mm >=
             control->config.curve_exit_minimum_travel_mm)) {
            if (control->curve_exit_cycles < UINT8_MAX) {
                ++control->curve_exit_cycles;
            }
            if (control->curve_exit_cycles >=
                control->config.curve_exit_confirm_cycles) {
                line_control_clear_curve_memory(control);
            }
        } else {
            control->curve_exit_cycles = 0U;
        }
        return;
    }
    if (suppress_reversal || !line_valid) {
        return;
    }
    if ((sample->black_bits == 0x01U) && (side == 1)) {
        control->curve_memory_side = 1;
        control->curve_travel_mm = 0.0f;
        control->curve_exit_cycles = 0U;
    } else if ((sample->black_bits == 0x08U) && (side == -1)) {
        control->curve_memory_side = -1;
        control->curve_travel_mm = 0.0f;
        control->curve_exit_cycles = 0U;
    }
}

static float line_control_curve_correction(
    const chassis_track_line_control_t *control,
    const line_sample_t *sample, bool line_valid,
    float linear_mm_s, float pd_correction_mm_s)
{
    float boost;
    float hold;
    float correction;
    uint32_t taper_end_ms;
    float taper_progress;

    if (!control->config.curve_memory_enabled ||
        (control->curve_memory_side == 0)) {
        return pd_correction_mm_s;
    }
    boost = line_control_min(
        linear_mm_s * control->config.outer_single_correction_ratio,
        control->config.outer_single_maximum_correction_mm_s);
    hold = line_control_curve_hold_magnitude(control, linear_mm_s);

    if (!line_valid) {
        taper_end_ms =
            (uint32_t) control->config.outer_lost_full_boost_ms +
            (uint32_t) control->config.outer_lost_taper_ms;
        if (control->lost_ms <=
            control->config.outer_lost_full_boost_ms) {
            correction = boost;
        } else if ((uint32_t) control->lost_ms < taper_end_ms) {
            taper_progress =
                ((float) control->lost_ms -
                 (float) control->config.outer_lost_full_boost_ms) /
                (float) control->config.outer_lost_taper_ms;
            correction = boost + ((hold - boost) * taper_progress);
        } else {
            correction = hold;
        }
        return (float) control->curve_memory_side * correction;
    }
    if ((sample->black_bits == 0x06U) ||
        (sample->black_bits == 0x09U)) {
        return (float) control->curve_memory_side * hold;
    }
    correction = ((float) control->curve_memory_side * hold) +
        pd_correction_mm_s;
    return line_control_limit_signed(correction, boost);
}

static float line_control_steering_bias(
    float line_correction_mm_s, float route_correction_mm_s,
    float maximum_correction_mm_s)
{
    float combined;

    if (line_correction_mm_s > 0.0f) {
        if (route_correction_mm_s < 0.0f) {
            route_correction_mm_s = 0.0f;
        }
        combined = line_correction_mm_s + route_correction_mm_s;
        return line_control_min(combined, maximum_correction_mm_s);
    }
    if (line_correction_mm_s < 0.0f) {
        if (route_correction_mm_s > 0.0f) {
            route_correction_mm_s = 0.0f;
        }
        combined = line_correction_mm_s + route_correction_mm_s;
        if (combined < -maximum_correction_mm_s) {
            return -maximum_correction_mm_s;
        }
        return combined;
    }
    if (route_correction_mm_s > maximum_correction_mm_s) {
        return maximum_correction_mm_s;
    }
    if (route_correction_mm_s < -maximum_correction_mm_s) {
        return -maximum_correction_mm_s;
    }
    return route_correction_mm_s;
}

static void line_control_limit_wheels(
    const chassis_track_line_control_t *control,
    chassis_track_line_control_output_t *output)
{
    float maximum_magnitude = line_control_abs(output->left_mm_s);
    float scale;

    if (line_control_abs(output->right_mm_s) > maximum_magnitude) {
        maximum_magnitude = line_control_abs(output->right_mm_s);
    }
    if (maximum_magnitude > control->config.maximum_wheel_speed_mm_s) {
        scale = control->config.maximum_wheel_speed_mm_s /
            maximum_magnitude;
        output->left_mm_s *= scale;
        output->right_mm_s *= scale;
        output->correction_mm_s *= scale;
        output->final_steering_bias_mm_s *= scale;
    }
}

ml_status_t chassis_track_line_control_init(
    chassis_track_line_control_t *control,
    const chassis_track_line_control_config_t *config)
{
    ml_status_t status;

    if ((control == 0) || !line_control_config_valid(config)) {
        return ML_STATUS_INVALID_ARGUMENT;
    }
    control->config = *config;
    control->initialized = false;
    status = pid_init(&control->pid, POSITION_PID,
        config->kp, config->ki, config->kd);
    if (status == ML_STATUS_OK) {
        status = pid_set_limits(&control->pid,
            -config->pid_output_limit, config->pid_output_limit,
            -config->pid_integral_limit, config->pid_integral_limit);
    }
    if (status == ML_STATUS_OK) {
        control->initialized = true;
        chassis_track_line_control_reset(control);
    }
    return status;
}

void chassis_track_line_control_reset(
    chassis_track_line_control_t *control)
{
    if ((control == 0) || !control->initialized) {
        return;
    }
    (void) pid_reset(&control->pid);
    control->last_line_error = 0.0f;
    control->pending_line_error = 0.0f;
    control->curve_travel_mm = 0.0f;
    control->last_valid_black_bits = 0U;
    control->accepted_side = 0;
    control->pending_side = 0;
    control->curve_memory_side = 0;
    control->pending_cycles = 0U;
    control->curve_exit_cycles = 0U;
    control->lost_ms = 0U;
    line_control_clear_curve_exit_fade(control);
    control->last_final_steering_bias_mm_s = 0.0f;
    control->has_valid_error = false;
}

static ml_status_t line_control_update_internal(
    chassis_track_line_control_t *control, const line_sample_t *sample,
    float requested_linear_mm_s, float requested_angular_rad_s,
    const chassis_track_line_fusion_request_t *fusion_request,
    bool formal_fusion,
    chassis_track_line_control_output_t *output)
{
    chassis_track_line_state_t state;
    float line_error = 0.0f;
    float pid_output;
    float linear_mm_s = requested_linear_mm_s;
    float angular_rad_s = requested_angular_rad_s;
    float half_track;
    float steering_bias_mm_s;
    float maximum_correction_mm_s;
    float previous_final_steering_bias_mm_s;
    uint8_t previous_valid_black_bits;
    bool line_valid;
    bool first_valid;
    bool outer_single_boost;
    bool curve_exit_transition;
    bool suppress_reversal;
    ml_status_t status;

    if ((control == 0) || !control->initialized) {
        return ML_STATUS_NOT_INITIALIZED;
    }
    if ((sample == 0) || (output == 0) || sample->io_fault ||
        !line_control_float_valid(requested_linear_mm_s) ||
        !line_control_float_valid(requested_angular_rad_s) ||
        (requested_linear_mm_s < 0.0f)) {
        return ML_STATUS_INVALID_ARGUMENT;
    }

    previous_final_steering_bias_mm_s =
        control->last_final_steering_bias_mm_s;
    previous_valid_black_bits = control->last_valid_black_bits;
    line_valid = line_control_centroid_error(
        sample->black_bits, &line_error);
    if (!line_valid) {
        if (control->lost_ms <= UINT16_MAX -
            control->config.control_period_ms) {
            control->lost_ms = (uint16_t) (control->lost_ms +
                control->config.control_period_ms);
        } else {
            control->lost_ms = UINT16_MAX;
        }
    } else {
        control->last_valid_black_bits = sample->black_bits;
        control->lost_ms = 0U;
    }
    first_valid = line_control_filter_error(control,
        line_valid, line_error, &line_error);
    suppress_reversal = line_valid &&
        (control->pending_cycles != 0U);
    line_control_update_curve_memory(control, sample,
        line_valid, suppress_reversal, linear_mm_s);
    outer_single_boost = line_control_outer_single(
        control->last_valid_black_bits);
    maximum_correction_mm_s = outer_single_boost ?
        control->config.outer_single_maximum_correction_mm_s :
        control->config.maximum_correction_mm_s;
    state = line_control_classify(line_valid, line_error);
    control->pid.target = line_error;
    control->pid.now = 0.0f;
    if (first_valid) {
        control->pid.error[1] = line_error;
        control->pid.error[2] = line_error;
    }
    status = pid_cal(&control->pid);
    if (status != ML_STATUS_OK) {
        return status;
    }
    pid_output = control->pid.out;
    if (suppress_reversal) {
        pid_output = 0.0f;
    }

    output->correction_mm_s = line_control_correction(
        control, pid_output, linear_mm_s, outer_single_boost);
    if (!suppress_reversal) {
        output->correction_mm_s = line_control_curve_correction(
            control, sample, line_valid, linear_mm_s,
            output->correction_mm_s);
    }
    if (control->config.curve_memory_enabled &&
        (control->curve_memory_side != 0)) {
        maximum_correction_mm_s =
            control->config.outer_single_maximum_correction_mm_s;
    }
    half_track = control->config.effective_track_mm * 0.5f;
    if (formal_fusion) {
        output->route_feedforward_bias_mm_s = fusion_request->heading_only ?
            0.0f : fusion_request->route_feedforward_rad_s * half_track;
        output->heading_feedback_bias_mm_s =
            fusion_request->heading_feedback_rad_s * half_track;
        if (fusion_request->heading_only) {
            output->line_weight = 0.0f;
            steering_bias_mm_s = line_control_limit_signed(
                output->heading_feedback_bias_mm_s,
                control->config.maximum_correction_mm_s);
        } else {
            output->line_weight = 1.0f;
            steering_bias_mm_s = line_control_steering_bias(
                output->correction_mm_s,
                output->route_feedforward_bias_mm_s +
                    output->heading_feedback_bias_mm_s,
                maximum_correction_mm_s);
        }
    } else {
        output->route_feedforward_bias_mm_s =
            angular_rad_s * half_track;
        output->heading_feedback_bias_mm_s = 0.0f;
        output->line_weight = 1.0f;
        steering_bias_mm_s = line_control_steering_bias(
            output->correction_mm_s,
            output->route_feedforward_bias_mm_s,
            maximum_correction_mm_s);
    }
    curve_exit_transition = control->config.curve_exit_fade_ms > 0U &&
        line_valid &&
        !line_control_outer_single(sample->black_bits) &&
        line_control_outer_single(previous_valid_black_bits);
    if (line_valid && line_control_outer_single(sample->black_bits)) {
        line_control_clear_curve_exit_fade(control);
    } else if (curve_exit_transition &&
               (control->curve_exit_fade_remaining_ms == 0U)) {
        control->curve_exit_fade_start_final_bias_mm_s =
            previous_final_steering_bias_mm_s;
        control->curve_exit_fade_remaining_ms =
            control->config.curve_exit_fade_ms;
    }
    if (control->curve_exit_fade_remaining_ms > 0U) {
        float fade_ratio;
        uint16_t remaining_ms = control->curve_exit_fade_remaining_ms;

        fade_ratio = 1.0f - ((float) remaining_ms /
            (float) control->config.curve_exit_fade_ms);
        steering_bias_mm_s =
            control->curve_exit_fade_start_final_bias_mm_s +
            (steering_bias_mm_s -
             control->curve_exit_fade_start_final_bias_mm_s) *
            fade_ratio;
        if (control->curve_exit_fade_remaining_ms >
            control->config.control_period_ms) {
            control->curve_exit_fade_remaining_ms = (uint16_t)
                (control->curve_exit_fade_remaining_ms -
                control->config.control_period_ms);
        } else {
            line_control_clear_curve_exit_fade(control);
        }
    }
    output->final_steering_bias_mm_s = steering_bias_mm_s;
    output->left_mm_s = linear_mm_s - steering_bias_mm_s;
    output->right_mm_s = linear_mm_s + steering_bias_mm_s;
    line_control_limit_wheels(control, output);
    output->linear_mm_s = 0.5f *
        (output->left_mm_s + output->right_mm_s);
    output->angular_rad_s =
        (output->right_mm_s - output->left_mm_s) /
        control->config.effective_track_mm;
    output->lost_ms = control->lost_ms;
    output->line_state = state;
    output->line_valid = line_valid;
    output->recovering = !line_valid;
    control->last_final_steering_bias_mm_s =
        output->final_steering_bias_mm_s;
    return ML_STATUS_OK;
}

ml_status_t chassis_track_line_control_update(
    chassis_track_line_control_t *control, const line_sample_t *sample,
    float requested_linear_mm_s, float requested_angular_rad_s,
    chassis_track_line_control_output_t *output)
{
    return line_control_update_internal(control, sample,
        requested_linear_mm_s, requested_angular_rad_s,
        0, false, output);
}

ml_status_t chassis_track_line_control_update_fused(
    chassis_track_line_control_t *control, const line_sample_t *sample,
    const chassis_track_line_fusion_request_t *request,
    chassis_track_line_control_output_t *output)
{
    if ((request == 0) ||
        !line_control_float_valid(request->linear_mm_s) ||
        !line_control_float_valid(request->route_feedforward_rad_s) ||
        !line_control_float_valid(request->heading_feedback_rad_s) ||
        !line_control_float_valid(request->heading_error_deg)) {
        return ML_STATUS_INVALID_ARGUMENT;
    }
    return line_control_update_internal(control, sample,
        request->linear_mm_s,
        request->route_feedforward_rad_s +
            request->heading_feedback_rad_s,
        request, true, output);
}
