chushengzhink/2026tibei-mspm0g3507-icm42688/ml_libs/ml_motor.h

#ifndef ML_MOTOR_H
#define ML_MOTOR_H

#include <stdint.h>

#include "ml_common.h"
#include "ml_encoder.h"
#include "ml_motor_driver.h"

ml_status_t motor_init(void);
ml_status_t motorA_duty(int32_t duty);
ml_status_t motorB_duty(int32_t duty);
ml_status_t encoder_init(void);
ml_status_t encoder_get_and_clear(int32_t *count1, int32_t *count2);

extern volatile int32_t Encoder_count1;
extern volatile int32_t Encoder_count2;
extern uint8_t motorA_dir;
extern uint8_t motorB_dir;

#endif
