chushengzhink/2026tibei-mspm0g3507-icm42688/code/q3_ball_app.c

#include "q3_ball_app.h"

#include <string.h>

#include "ml_board.h"
#include "ml_delay.h"
#include "ml_gpio.h"
#include "ml_oled.h"
#include "ml_uart.h"
#include "q3_ball.h"
#include "q3_ball_config.h"
#include "q3_ball_telemetry.h"

#define Q3_APP_KEY_DEBOUNCE_MS       (40U)
#define Q3_OLED_INIT_RETRIES          (3U)
#define Q3_OLED_RETRY_PERIOD_MS       (500U)
#define Q3_OLED_RETRY_DELAY_MS        (50U)
#define Q3_OLED_REDRAW_DELAY_MS       (20U)
#define Q3_OLED_TEST_HOLD_MS          (400U)
#define Q3_OLED_DISPLAY_PERIOD_MS     (100U)
#define Q3_OLED_WAIT_DISPLAY_PERIOD_MS (500U)
#define Q3_OLED_DIAG_REPEAT_MS        (2000U)
#define Q3_OLED_BLINK_PERIOD_MS       (250U)

typedef struct {
    bool raw_pressed;
    bool stable_pressed;
    bool armed;
    bool press_event;
    uint32_t raw_change_ms;
} q3_key_t;

typedef struct {
    q3_key_t center_key;
    q3_state_t last_state;
    bool initialized;
    bool have_state;
    bool oled_ready;
    bool oled_fault;
    bool oled_dirty;
    bool oled_line_valid[OLED_TEXT_LINE_COUNT];
    char oled_line[OLED_TEXT_LINE_COUNT][OLED_TEXT_COLUMN_COUNT + 1U];
    bool led_ready;
    bool uart0_ready;
    bool map_exported;
    bool telemetry_finished;
    bool telemetry_recorded;
    bool core_failed;
    uint8_t oled_attempts;
    q3_core_init_stage_t core_stage;
    ml_status_t core_error;
    ml_status_t uart0_error;
    uint32_t oled_error;
    uint32_t oled_last_retry_ms;
    uint32_t oled_last_display_ms;
    uint32_t oled_last_diag_ms;
    uint32_t oled_last_diag_error;
    uint32_t led_last_toggle_ms;
    uint32_t telemetry_last_record_ms;
    q3_vision_diag_t wait_oled_diag;
    uint8_t wait_oled_streak;
    bool wait_oled_have_diag;
} q3_app_context_t;

static q3_app_context_t g_app;

static void q3_send_byte(uint8_t byte)
{
    if (g_app.uart0_ready) {
        (void) uart_sendbyte(Q3_TELEMETRY_UART, byte);
    }
}

static void q3_send_text(const char *text)
{
    while (*text != '\0') {
        q3_send_byte((uint8_t) *text++);
    }
}

static void q3_send_u32(uint32_t value)
{
    char digits[10];
    uint8_t count = 0U;

    do {
        digits[count++] = (char) ('0' + (value % 10U));
        value /= 10U;
    } while ((value != 0U) && (count < sizeof(digits)));
    while (count > 0U) {
        q3_send_byte((uint8_t) digits[--count]);
    }
}

static void q3_send_fixed(int32_t scaled, uint32_t divisor)
{
    uint32_t magnitude;
    uint32_t place;

    if (scaled < 0) {
        q3_send_byte((uint8_t) '-');
        magnitude = (uint32_t) (-(scaled + 1)) + 1U;
    } else {
        magnitude = (uint32_t) scaled;
    }
    q3_send_u32(magnitude / divisor);
    q3_send_byte((uint8_t) '.');
    for (place = divisor / 10U; place > 0U; place /= 10U) {
        q3_send_byte((uint8_t) ('0' + ((magnitude / place) % 10U)));
    }
}

static int32_t q3_scaled(float value, float scale)
{
    float result = value * scale;

    return (int32_t) (result + ((result >= 0.0f) ? 0.5f : -0.5f));
}

static bool q3_center_pressed(void)
{
    return gpio_get(ML_KEY_CENTER_PORT, ML_KEY_CENTER_PIN) ==
        ML_KEY_ACTIVE_LEVEL;
}

static void q3_key_init(q3_key_t *key, bool pressed)
{
    memset(key, 0, sizeof(*key));
    key->raw_pressed = pressed;
    key->stable_pressed = pressed;
    key->armed = !pressed;
}

static void q3_key_update(q3_key_t *key, bool pressed, uint32_t now_ms)
{
    key->press_event = false;
    if (pressed != key->raw_pressed) {
        key->raw_pressed = pressed;
        key->raw_change_ms = now_ms;
    }
    if ((key->stable_pressed != key->raw_pressed) &&
        ((now_ms - key->raw_change_ms) >= Q3_APP_KEY_DEBOUNCE_MS)) {
        key->stable_pressed = key->raw_pressed;
        if (key->stable_pressed) {
            if (key->armed) {
                key->press_event = true;
            }
            key->armed = false;
        } else {
            key->armed = true;
        }
    }
}

static bool q3_state_is_boot_motion(q3_state_t state)
{
    return (state >= Q3_STATE_BOOT_SETTLE) &&
        (state <= Q3_STATE_BOOT_RECENTER);
}

static bool q3_state_is_formal_motion(q3_state_t state)
{
    return (state >= Q3_STATE_PLUS_DRIVE) &&
        (state <= Q3_STATE_COMPLETE);
}

static bool q3_state_is_map_motion(q3_state_t state)
{
    return (state == Q3_STATE_MAP_TO_PLUS) ||
        (state == Q3_STATE_MAP_TO_MINUS) ||
        (state == Q3_STATE_MAP_RETURN_CENTER);
}

static bool q3_state_is_motion(q3_state_t state)
{
    return q3_state_is_boot_motion(state) ||
        q3_state_is_formal_motion(state) ||
        q3_state_is_map_motion(state);
}

static bool q3_state_is_neutral_terminal(q3_state_t state)
{
    return (state == Q3_STATE_TIMEOUT) ||
        (state == Q3_STATE_ABORTED) ||
        (state == Q3_STATE_VISION_FAULT) ||
        (state == Q3_STATE_PROFILE_FAULT) ||
        (state == Q3_STATE_CALIBRATION_FAULT);
}
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
