chushengzhink/2026tibei-mspm0g3507-icm42688/(commit log)

2026-07-26 初始化工程并新增 ICM42688 I²C 支持
    [Configuration_NVM_disable_PA18_MSPM0G_firmware_v1.txt, Configuration_NVM_disable_PA18_MSPM0L_firmware_v1.txt, MSPM0_SDK_syscfg_menu_import.cfg, xdsalias.cfg, xdserror.cfg, xdsfamily.cfg, xdsinitial.cfg]
2026-07-27 新增 ICM42688 六轴姿态解算并修复定时器时基
2026-07-27 模块化封装 ICM42688 姿态服务
2026-07-27 重构固件模块并完善主机测试
2026-07-30 终于调好了红外
2026-07-30 添加稳定的红外循迹，过弯可以，但是直线行走巡线有些不太稳定，即有些左右摇摆的幅度
2026-07-30 更好的红外循迹
2026-07-30 停用纯红外弯道记忆防止直线误转
2026-07-30 红外+iMU +编码器，巡线更稳了，就差停车距离了
2026-07-30 最好的红外循迹以及定位，还有初始化平台
2026-07-30 首板调球
2026-07-31 +5爱上了-5
2026-07-31 悲伤不会落泪是天空下起了雨
2026-07-31 道爷我成了
2026-07-31 我们的爱
2026-07-31 无敌之姿
2026-07-31 +5基本完成-5无法停止
2026-07-31 第4问基本
2026-07-31 第四问弄好了
2026-07-31 第五题基本
